calvinNdmb/Pixel-ai-dashboard/pixel-app/docs/AMIS.md

# Les amis de Pixel

Ton Pixel peut rendre visite au Pixel d'un copain, d'une maison à l'autre, comme le Pixel de poche part dans ton téléphone. Il sort de ton écran avec sa petite valise, arrive sur l'écran de son ami, à côté de lui, et ils jouent ensemble environ 3 minutes : ils se disent bonjour, dansent, se tapent dans les mains, font la course, goûtent, jouent à cache-cache, se racontent une blague, bavardent, font une photo souvenir… et s'endorment côte à côte s'il est tard. Puis il rentre chez toi et te raconte : « J'ai joué avec Bip ! On a dansé, et on a fait la course ! »

Rien ne passe par un serveur à nous, et tu n'as rien à ouvrir sur ta box : les deux Pixels se parlent par un **relais** public (ntfy.sh, ou le tien), et tout ce qui y passe est **chiffré** : le relais ne voit ni les noms, ni les codes, ni ce que font les Pixels. Tant que ton Pixel n'a pas d'ami, il ne contacte même pas le relais.

## Devenir amis

1. Sur le téléphone de ton Pixel, touche **Amis** sous les touches (le panneau **Ses amis**), puis **Créer mon code**. Ton code d'ami s'affiche : **trois mots et un nombre**, par exemple `lapin · soleil · tarte · 4271`, avec un QR code. Tu peux aussi le montrer en grand sur l'écran de Pixel (**Montrer sur l'écran de Pixel**, ou tape `mon code d'ami`).
2. Donne ce code à ton copain : lis-le-lui au téléphone, écris-le-lui, ou montre-lui le QR code (son appareil photo affiche le texte, il peut le copier).
3. Chez lui, sur son Pixel : panneau **Ses amis**, partie **Ajouter un ami**, il tape le code et touche **Ajouter**. Ou il tape la commande `ajoute l'ami lapin soleil tarte 4271`. Les majuscules, les accents, les tirets et les espaces ne comptent pas. Un mot mal tapé ? Le panneau le dit tout de suite, et propose le bon (« lapon » : « Tu voulais dire lapin ? »).
4. En une seconde, les deux Pixels sont amis : sur les deux écrans, Pixel fait la fête (« J'ai un nouvel ami ! Il s'appelle Bip ! ») et la tête de son ami passe le bout du nez dans le coin.

Le code marche **une seule fois**, pendant **24 heures**. Les deux Pixels doivent être allumés. Pour un autre ami, crée un autre code. **Annuler ce code** l'efface.

**Astuce :** donne d'abord un nom à ton Pixel (panneau **Caractère**, ou `appelle-toi Bip`) : c'est ce nom que voient ses amis. Deux amis qui s'appellent pareil deviennent « Pixel » et « Pixel 2 ».

## Les visites

- **Va le voir :** dans **Ses amis**, le bouton **Va le voir** à côté de ton ami. Ou tape `va voir Bip`. Ou demande à Claude « va voir Bip ».
- Ton Pixel quitte ton écran avec sa valise. À la place, une petite maison : « Chez Bip », le temps qu'il reste, et le bouton **Rappelle-le** (touche-le pour le faire rentrer tout de suite ; tape aussi `reviens`).
- Chez Bip, il entre par la droite, Bip se pousse un peu à gauche, et ils jouent. Leurs noms sont écrits sous eux. Ton Pixel garde le look qu'il a choisi (s'il en a un), habillé par la saison et la météo de chez Bip, dans les couleurs du thème de Bip.
- À la fin, il rentre et raconte ce qu'ils ont fait. La visite va dans le journal de **Ses amis**, et dans son album s'il en a un.
- **Bip ne répond pas ?** Au bout de 25 secondes, ton Pixel revient : « Bip n'a pas répondu… il doit dormir. » Son Pixel est peut-être éteint.
- **Bip ne peut pas ?** Ton Pixel revient et te dit pourquoi : il dort (de son coucher à son réveil, pendant sa sieste ; sans emploi du temps, ses heures calmes), il est occupé (quelque chose est casté sur son écran, il joue à un de ses jeux, ou il vient d'avoir de la visite et se repose 5 minutes), il fait des maths (un exo est ouvert), il a déjà de la visite, il est lui-même parti en visite, ou il ne reçoit pas de visite en ce moment. Si vous partez chacun chez l'autre en même temps : « On s'est croisés ! » Et ton Pixel lui-même ne part pas quand il dort, pendant un exo, une partie, ou quand il est dans ta poche.
- **L'heure du dodo pendant une visite :** si ton Pixel s'endort chez Bip (son coucher, sa sieste), il rentre ; si c'est Bip qui s'endort pendant qu'il est chez toi, Bip dit au revoir et repart.
- **Un souvenir et une photo par jour et par ami :** la première visite du jour avec Bip (chez lui ou chez toi) va dans l'album ; les suivantes, le même jour, vont seulement dans le journal.

**Quand un ami vient chez toi**, tu n'as rien à faire : il entre, ils jouent, il repart. Touche-le : il rigole. **Raccompagner** (dans **Ses amis**) le fait repartir plus tôt.

**Sur l'écran du Pi, une chose à la fois :** ce que tu castes, le menu rapide et un exo ouvert passent devant la visite, et une partie aussi (mais pas de partie pendant une visite, ni de visite pendant une partie). Elle attend dessous, son temps continue, et revient après. Pendant une visite, l'assiette des repas se range, et Pixel ne te propose ni question de maths ni partie, ne te demande pas comment tu vas et ne montre pas son album : tout cela revient après. Une blague, un repas, une photo, un nouveau look pendant la visite : ton Pixel le fait, son ami le regarde, puis ils reprennent là où en est la visite. Un coucou ou un autocollant arrivé pendant une partie ou un exo attend leur fin pour se montrer.

## Coucous et autocollants

- **Coucou** fait coucou à ton ami : sur son écran, ta tête passe dans le coin et le salue. Tape aussi `dis coucou à Bip`.
- **Autocollant** : un des 12 dessins (un cœur, une étoile, un soleil, un arc-en-ciel, un pouce levé, un fou rire, une fleur, un gâteau, une fusée, un cadeau, une note de musique, un bisou). Tape aussi `envoie un cœur à Bip`.
- Il n'y a **pas de texte libre** entre deux maisons : seulement ces coucous, ces autocollants et les visites.
- Si son Pixel dort, le coucou attend dans son journal.

## Réglages et parents

Dans **Ses amis**, partie **Réglages** :
- **Accepter les visites** (allumé au départ) : éteint, les amis ne peuvent plus venir.
- **Me demander avant** (éteint au départ) : quand un ami frappe, Pixel affiche « Bip veut venir jouer ! » avec **Non merci** et **Oui !**, sur son écran et dans le panneau. Sans réponse en 45 secondes, c'est non.
- **Amis** : l'interrupteur des parents. Éteint, plus rien ne sort ni n'arrive : pas de visite, pas de coucou, plus de connexion au relais.
- Pour verrouiller pour de bon, sur le Pi : `enabled = false` dans la partie `[amis]` de `config.toml` (le bouton du téléphone ne le rallume pas).

**Retirer un ami :** **Retirer** (touche deux fois). Les deux Pixels oublient l'amitié et sa clé. Si son Pixel est éteint plus de 12 heures, il ne l'apprendra pas tout seul : retire-le aussi de son côté.

**Le journal** (« Ce qui s'est passé ») garde les 30 dernières choses : nouveaux amis, visites dans les deux sens et ce qu'ils ont fait, refus, coucous, autocollants.

**Au plus 20 amis.**

## Ce qui protège les enfants

- Seuls les Pixels qui ont échangé un code peuvent joindre le tien. Le code marche une fois, 24 heures, et ne voyage jamais (ni dans le relais, ni ailleurs).
- Aucun texte libre, aucune photo, aucune position, aucun prénom ne passe d'une maison à l'autre. **Ce qu'un ami apprend, exactement :**
  - sa carte : le nom de ton Pixel (des lettres, 16 au plus), son caractère, son thème, le look que tu lui as choisi (forme et couleur des yeux, couleur des joues, accessoires choisis, et si les tenues des saisons et le pyjama sont permis), et un numéro au hasard. Jamais ce qu'il porte en ce moment : son pyjama dirait l'heure de son coucher, son chapeau de fête le jour de ton anniversaire. L'écran de ton ami l'habille lui-même, avec sa propre date ;
  - quand ton Pixel répond (il est allumé), et, quand une visite est refusée, pourquoi : il dort (sa nuit ou sa sieste), il est occupé (un cast, ou il se repose après une visite), il fait des maths, il est sorti ou dans ta poche, il a déjà de la visite, il ne reçoit pas de visite, ta famille a dit non ou n'a pas répondu ;
  - pendant une visite chez toi : ce qu'ils ont fait, la durée prévue, et s'ils ont fait la sieste côte à côte (chez toi, après 20 h) ;
  - les coucous, les autocollants et les visites que tu lui envoies, et quand ; le retrait de son Pixel de tes amis (« au revoir »).
- Tout ce qui passe par le relais est chiffré et signé : un message modifié, rejoué, trop vieux ou pas pour toi est jeté.
- Tout est limité : 20 amis, un coucou toutes les 20 secondes par ami, un autocollant toutes les 8 secondes, 150 messages par jour (rien de plus ne part, pas même une réponse), une visite à la fois, 30 messages par minute reçus d'un même ami (le reste est jeté sans être lu).
- Et ce qu'un Pixel ami peut faire faire au tien, même un Pixel modifié qui ne respecte aucune règle : ses demandes de visite sont écoutées au plus une toutes les 25 secondes et 20 par heure (les autres restent sans réponse) ; les réponses automatiques s'arrêtent avant les 30 derniers messages du jour, gardés pour les tiens ; après une visite (ou un « Non merci »), ton Pixel se repose 5 minutes (`repos_secondes` dans `[amis]` de `config.toml`) ; un souvenir et une photo par jour et par ami ; ses messages ne font écrire `amis.json` qu'une fois toutes les 10 secondes au plus.
- Un code d'ami tapé par un Pixel qui se présente avec le numéro d'un de tes amis est refusé (« Bip est déjà ton ami ! ») : personne ne peut prendre la place d'un ami.
- Au plus 6 nouveaux codes en 10 minutes ; leur calcul (scrypt) se fait un à la fois, à part.
- L'interrupteur **Amis** et le verrou de `config.toml`, le journal pour voir ce qui s'est passé, **Me demander avant** pour décider de chaque visite.

## Sans Pi, et dans Pixel Lab

**Pixel sans Pi** (l'appli Android sans le Pi) n'a pas encore d'amis : ses amis et leurs clés vivent sur le Pi. Les commandes des amis disent « Relie Pixel à ton Pi pour ça ».

**Pixel Lab** a un ami de démo, **Bip**, joué par un faux relais dans la page (rien ne sort de la page) : dans le panneau **Les amis**, **Il vient te voir** fait venir Bip (avec les mêmes scènes que sur le Pi), **Va voir Bip** envoie Pixel chez lui, **Il fait coucou**, ses autocollants, **Il dort**, **Il ne répond pas**, et chaque scène à deux, toute seule. Les visites y durent 30 secondes (**Visites courtes**). **Un copain tape mon code** te fait un nouvel ami de démo. Tu peux aussi taper n'importe quel code bien formé dans **Ajouter un ami**.

## Ton propre relais

Le relais par défaut est [ntfy.sh](https://ntfy.sh), un service public et gratuit (il garde les messages 12 heures, puis les efface). Tu peux en installer un à toi (ntfy est un logiciel libre : `docker run -p 80:80 binwiederhier/ntfy serve`, ou sur un petit serveur), puis, dans `config.toml` :

```toml
[amis]
relay = "https://ntfy.mamaison.fr"
# token = "tk_..."          # si ton relais demande un jeton d'accès
```

Les deux Pixels amis doivent utiliser le même relais. Rien d'autre n'est demandé au relais que de transmettre des messages qu'il ne peut pas lire.

---

## Comment c'est fait (pour les curieux et les développeurs)

**Fichiers.** `pixel/relais.py` : le client ntfy et la boîte chiffrée ; `pixel/amis.py` : les codes, les amitiés, les visites, les commandes, l'outil de Claude, `amis.json` ; `web/amis.js` : l'écran du Pi et le panneau du téléphone ; `web/scenes/amis.js` : les scènes (la part de l'hôte, `S(...)`, et celle du visiteur, `PixelAmisDuo`), les autocollants et les accessoires (`PixelAmisArt`), les mots de ce qu'ils ont fait ; `web/lab/amis-lab.js` : le miroir du labo et son ami de démo ; `tests/test_amis.py`, `tests/test_amis.js`, `tests/fake_ntfy.py`.

**Le relais (ntfy).** Publier : `POST {relais}/{sujet}` (le corps est le message, du texte ; en-tête `X-Firebase: no`). S'abonner : `GET {relais}/{s1},{s2},…/json?since={heure unix}`, une ligne JSON par message (`open`, puis les messages gardés depuis `since`, puis chaque nouveau, et un `keepalive` toutes les 45 s). Pixel garde **un seul flux** pour tous ses sujets, ouvert seulement quand il y en a un (un ami, un code, un code tapé). Coupé, il se reconnecte avec une attente qui double (1 s à 5 min, avec un peu de hasard), et reprend avec `since=` (l'heure de son dernier message, gardée dans `amis.json`) : une coupure ne fait rien perdre de ce que le relais garde. 120 s sans rien : la liaison est morte, il se reconnecte. Un refus du relais (429) est dit, jamais réessayé en boucle.

**La boîte.** Chaque message est du JSON, complété par des espaces jusqu'à 512, 1 024 ou 2 400 octets (la première taille qui le contient : un coucou, une visite et une carte ont la même longueur sur le relais ; un Pixel 1.3.0 lit ces espaces comme du JSON ordinaire), chiffré en AES-256-GCM (nonce de 96 bits au hasard), avec le sujet comme donnée associée (copié sur un autre sujet, il ne s'ouvre plus) : `PXA1.` + base64url(nonce ‖ chiffré ‖ étiquette), soit 725, 1 408 ou 3 243 caractères (3 600 au plus). Paquet Python `cryptography` (dans `requirements.txt`, vérifié par `deploy/install.sh`).

**Ce que le relais voit quand même.** Celui qui tient le relais (ntfy.sh, ou toi) ne lit rien, mais il voit : les adresses IP des maisons qui publient et qui écoutent, les sujets (au hasard, mais les mêmes pour toute une amitié : deux par amitié, un seul flux par Pixel qui les écoute tous, donc combien d'amis a un Pixel et lesquels il partage avec qui), quand chaque message passe, et sa taille parmi les trois. Il sait donc qui parle à qui, quand et combien, pas ce qu'ils se disent.

**Le code d'ami.** Trois mots d'une liste de 512 (dans `web/amis.js` : des mots simples, sans deux qui se prononcent pareil) et un nombre de 1000 à 9999 : 512³ × 9000 ≈ 1,2 × 10¹² codes, **40,1 bits**. Le code est étiré par scrypt (n = 2¹⁵, r = 8, p = 1 : 32 Mo et environ une demi-seconde sur un Pi 4, à l'abri du serveur), puis HKDF-SHA256 en donne le **sujet de rendez-vous** et sa **clé**. Le code ne voyage jamais. Quelqu'un qui copierait tout le trafic du relais devrait essayer 10¹² codes à une demi-seconde chacun.
**La limite, honnêtement :** le sel de scrypt est fixe (le même pour tous les Pixels : les deux côtés n'ont que le code en commun) et il n'y a pas d'échange authentifié par mot de passe (PAKE). Quelqu'un qui calculerait une fois pour toutes la table des 1,2 × 10¹² codes (des milliers d'années de calcul pour un seul ordinateur, mais une seule fois pour tous les Pixels) reconnaîtrait chaque sujet de rendez-vous qu'il voit passer sur le relais, donc son code. Pendant les 24 heures du code, il pourrait lire les deux cartes échangées, et même se glisser entre les deux Pixels à ce moment-là (répondre à la place de l'un et de l'autre). Une amitié déjà faite n'est pas touchée : sa clé vient aussi de l'échange X25519. Un PAKE fermerait cette porte ; Pixel n'en a pas encore.

**Devenir amis.** Celui qui tape le code (B) publie sur le sujet de rendez-vous, scellé avec sa clé : `bonjour` {sa clé publique X25519 éphémère, sa carte d'identité}. Le propriétaire du code (A), qui écoute ce sujet tant que le code vit, répond `bienvenue` {sa clé publique éphémère, sa carte}, et efface le code (une seule fois). Chacun calcule le secret X25519 et en tire la **clé de l'amitié** : HKDF(secret, sel = le code étiré, info = « pxa1 ami » + SHA-256(clé de B | clé de A | sujet)). Elle dépend donc du code (seul qui le connaissait pouvait participer) et de l'échange (deviner le code plus tard n'ouvre rien : confidentialité persistante). B dit enfin `merci` sur le canal de l'amitié (deux fois, à 15 s d'écart) : A sait alors que B a la même clé, et les deux écrans montrent le nouvel ami. Un `bonjour` de plus de 2 minutes est ignoré (son auteur a abandonné) ; sans réponse en 90 s, B le dit ; A plein (20 amis) répond `complet`. Une carte qui porte le numéro d'un ami déjà là n'est jamais acceptée, ni par A (il répond `deja`, garde son code et dit « Bip est déjà ton ami ! ») ni par B (« Ce Pixel est déjà ton ami ! ») : on ne remplace pas un ami (pour refaire une amitié, chacun retire d'abord l'autre).

**La carte d'identité** (ce qu'un ami sait de l'autre, avec ce que disent les messages ci-dessous ; prête pour un futur village) : `{v: 1, id: 16 chiffres hexadécimaux au hasard, nom: le nom de son Pixel (pixel/caractere.py, nettoyé, 16 caractères au plus), caractere: son caractère tout prêt ou « perso », theme: son thème, look: le look choisi pour lui (yeux, couleur_yeux, couleur_joues, mono, accessoires, saisons, nuit : ses choix de `pixel/look.py`, jamais `porte`, ce qu'il porte en ce moment, ni `sans`, `change`, `avant` ; 1 Ko au plus, 4 niveaux, des clés simples, des textes de 64 caractères au plus)}`. L'écran de l'ami l'habille lui-même (saison, nuit) avec sa propre date ; dans la carte d'un Pixel plus ancien, `porte` est jeté à l'arrivée. Elle est renvoyée à ses amis quand elle change (au plus tous les quarts d'heure).

**Le canal d'une amitié.** De la clé de l'amitié, HKDF tire deux sujets (un par sens : « boite » + l'id du destinataire) et deux clés (« id de l'expéditeur > id du destinataire ») : un message renvoyé à son auteur, ou copié vers un autre ami, ne s'ouvre pas. Chaque message porte `{v, k (son type), de, a, t (heure en ms), id (16 hex au hasard)}` et il est refusé si : il ne s'ouvre pas, il n'est pas pour moi ou pas de cet ami, il vient du futur (plus de 10 min), il est trop vieux (une demande de visite : 90 s ; une réponse : 3 min ; la fin d'une visite : 20 min ; le reste : 24 h), ou son `id` a déjà été vu (les id des dernières 24 h sont gardés dans `amis.json`, donc même après un redémarrage).

**Les types de messages :** `merci`, `carte` {carte}, `au-revoir` (on oublie l'amitié), `coucou`, `sticker` {s : un des 12}, `visite-demande` {vid}, `visite-attente` {vid} (l'hôte demande à sa famille), `visite-ok` {vid, dur}, `visite-non` {vid, pourquoi : dort, occupe, exo, absent, visite, ferme, non, pas-repondu, croise}, `visite-fin` {vid, fait : ce qu'ils ont fait (des scènes de la liste), par : fin, hote, rappel}. Aucun champ de texte libre.

**Une visite.** L'hôte vérifie qu'il peut (réveillé : `endormi()` de `pixel/habitudes.py`, son emploi du temps de son coucher à son réveil et sa sieste, sinon les heures calmes de son caractère ; pas de cast, pas d'exo ouvert, pas de partie, pas déjà en visite, visites acceptées), puis fixe le **programme** (`programme()` : il arrive, des activités au hasard tant qu'elles tiennent, la photo souvenir, la sieste côte à côte s'il est tard (son coucher dans l'heure ; sans emploi du temps, après 20 h), au revoir ; environ 3 minutes, `visite_secondes` dans `config.toml`), que tous ses écrans jouent scène par scène à l'heure du serveur ; une scène d'une autre fonction (une blague, un repas, une photo…) se joue jusqu'au bout, puis la visite reprend là où en est son heure. À la fin, il envoie `visite-fin` avec ce qu'ils ont fait ; le visiteur rentre et le raconte. L'hôte écrit alors le souvenir de la visite, et la photo prise ensemble (« ami-photo », avant la fin) l'attend, pour aller avec ce souvenir-là. S'il s'endort pendant la visite (son coucher, sa sieste), l'hôte avance son au revoir (après sa propre « Bientôt l'heure du dodo ») ; le visiteur qui s'endort chez son ami envoie `visite-fin` (par : rappel) et rentre. Le visiteur rentre de lui-même 30 s après la fin prévue si l'hôte s'est tu, et au bout de 25 s sans réponse à sa demande.

**L'état « amis »** (ce que voient les écrans) : `{dispo, pourquoi, on, visites, demander, relais, lien (off, connexion, ok, coupe), max, moi (ma carte), code: {code, mots, nombre, expire, qr} | null, montre, ajout: {etat, pourquoi, nom, t} | null, amis: [{id, nom, caractere, theme, look, depuis, vu, visite, n, coucou}], arrivent, visite: {vid, sens (sortie | accueil), ami, nom, etat (demande, attente, chez, question), t0, jusqua, fin, programme, look, seed, par} | null, evs: [les dernières nouvelles], journal: [30]}`. Jamais les clés.

**Les actions :** `amis.code`, `amis.code_annule`, `amis.montre {on}`, `amis.ajoute {code}`, `amis.ajout_ok`, `amis.visite {ami}`, `amis.rappel`, `amis.raccompagne`, `amis.reponse {vid, oui}`, `amis.coucou {ami}`, `amis.sticker {ami, s}`, `amis.retire {ami}`, `amis.reglages {on, visites, demander}`. **Commandes :** `va voir Bip`, `dis coucou à Bip`, `envoie un cœur à Bip`, `mes amis`, `mon code d'ami`, `ajoute l'ami …`, `reviens` (seulement quand il est parti) ; un nom qui n'est pas celui d'un ami part à Claude, comme avant. **Claude :** l'outil `pixel_friends` {action : liste, visite ou coucou ; ami : son nom} ; il ne peut ni ajouter ni retirer d'ami, ni écrire.

**`amis.json`** (dans le dossier de données, lisible par son seul propriétaire : il garde les clés) : mon id, les réglages, les amis (carte, clé, dates, nombre de visites), le code en cours, le journal, les id déjà vus, `since`, le compte du jour, les amis dont la visite a déjà fait le souvenir et la photo du jour. Un fichier illisible est mis de côté (`amis.json.illisible`) et Pixel repart sans ami ; une valeur d'un mauvais type (une liste à la place d'un mot…) est seulement laissée de côté.

**Le futur village.** Les cartes d'identité (id, nom, caractère, thème, look), la liste des amis et leurs dates sont faites pour être réutilisées par un village où les Pixels cohabitent : il suffira d'un nouveau type de message, sans rien changer aux amitiés.

**Ce qui n'est vérifié qu'avec un vrai second Pi :** le vrai ntfy.sh (son `since`, ses limites, ses keepalives), le délai réel d'une maison à l'autre, scrypt sur un Pi 4, et une visite sur le vrai écran de 7 pouces. Les tests utilisent un faux relais (`tests/fake_ntfy.py`), jamais ntfy.sh.

```
python3 tests/test_amis.py      # le faux relais sur le port 8460 (AMIS_PY_PORT=… pour un autre)
node tests/test_amis.js         # le faux relais 8461, deux serveurs de démo 8462 et 8463 (AMIS_RELAY_PORT, AMIS_A_PORT, AMIS_B_PORT) ; --shots DOSSIER
```
