calvinNdmb/Pixel-ai-dashboard/cute-kit/stl/CatEarInnerLeft.stl

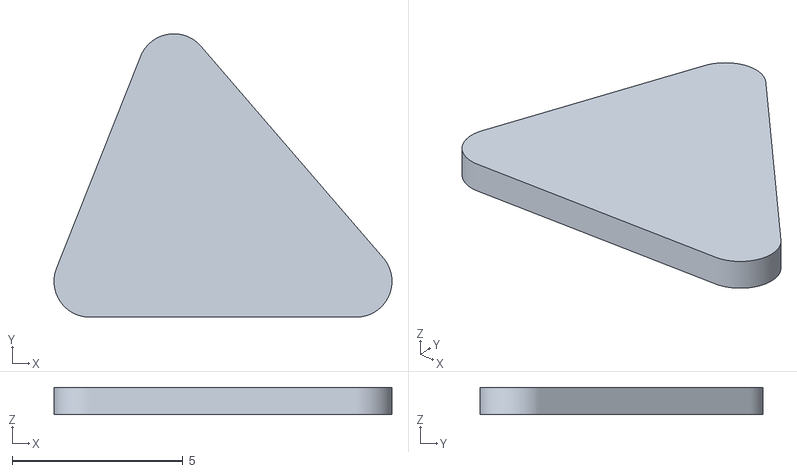
[picture p19: CAD file, 2026-11-05]
cute-kit/stl/CatEarInnerLeft.stl
9.90 x 8.30 x 0.8
