calvinNdmb/Pixel-ai-dashboard/pixel-desk/stl/ScreenFitTest.stl

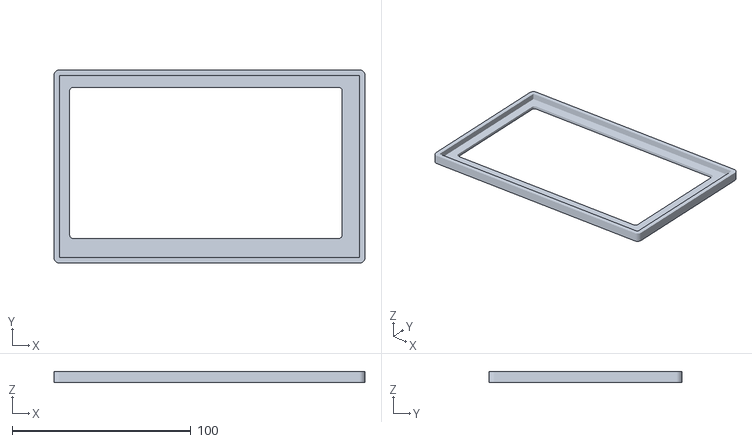
[picture p20: CAD file, 2026-11-09]
pixel-desk/stl/ScreenFitTest.stl
174.0 x 108.0 x 6.00
