calvinNdmb/Pixel-ai-dashboard/stream-deck-dock/stl/StreamDeckDock_MK2.stl

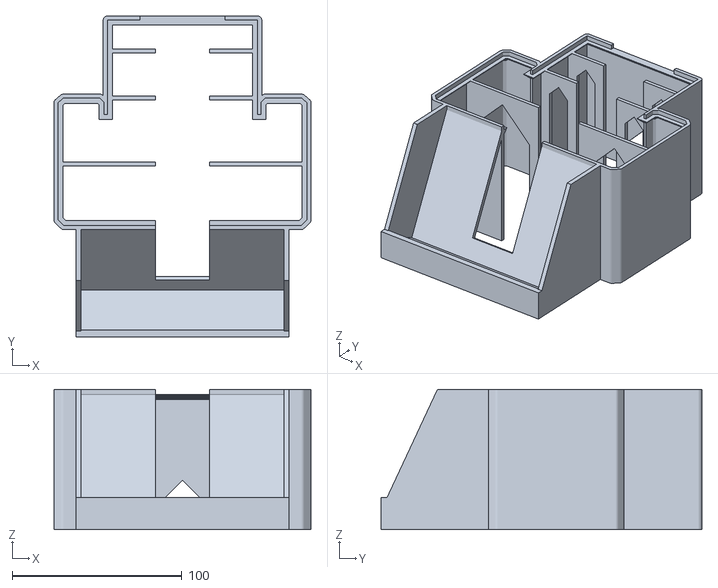
[picture p21: CAD file, 2026-11-05]
stream-deck-dock/stl/StreamDeckDock_MK2.stl
151.4 x 189.1 x 82.6
