calvinNdmb/Pixel-ai-dashboard/touch-head/stl/TouchHead.stl

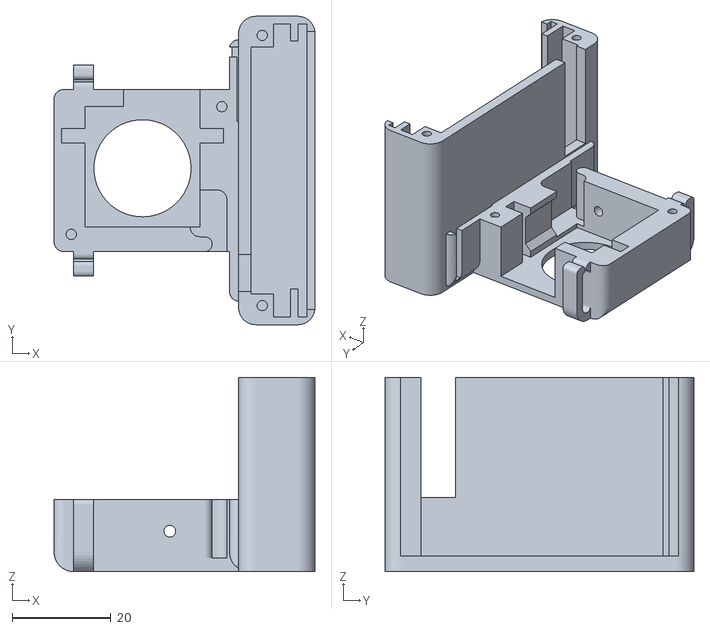
[picture p22: CAD file, 2026-11-05]
touch-head/stl/TouchHead.stl
53.0 x 62.6 x 39.4
