calvinNdmb/Pixel-ai-dashboard/cute-kit/stl/CatEarLeft.stl

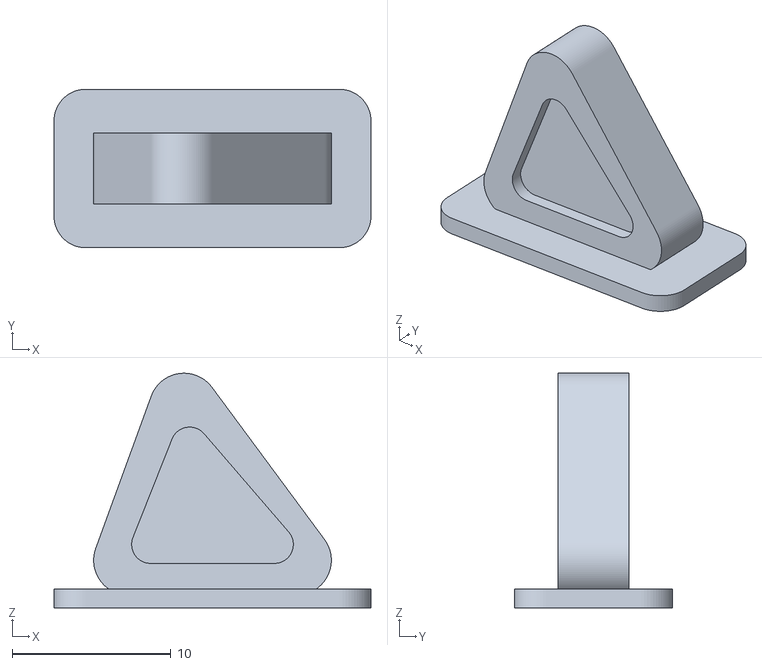
[picture p23: CAD file, 2026-11-05]
cute-kit/stl/CatEarLeft.stl
20.0 x 10.0 x 14.8
