calvinNdmb/Pixel-ai-dashboard/pixel-desk/stl/ScreenMountTest.stl

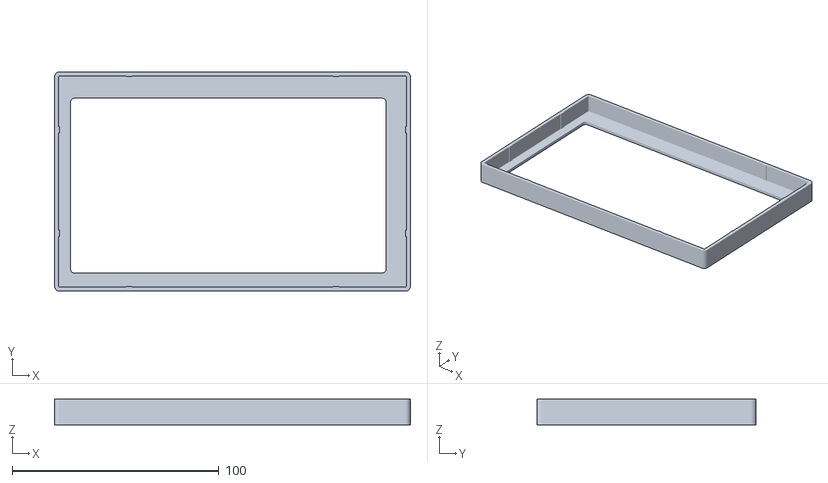
[picture p24: CAD file, 2026-11-09]
pixel-desk/stl/ScreenMountTest.stl
172.0 x 106.0 x 12.4
