calvinNdmb/Pixel-ai-dashboard/stream-deck-dock/stl/StreamDeckDock_Neo.stl

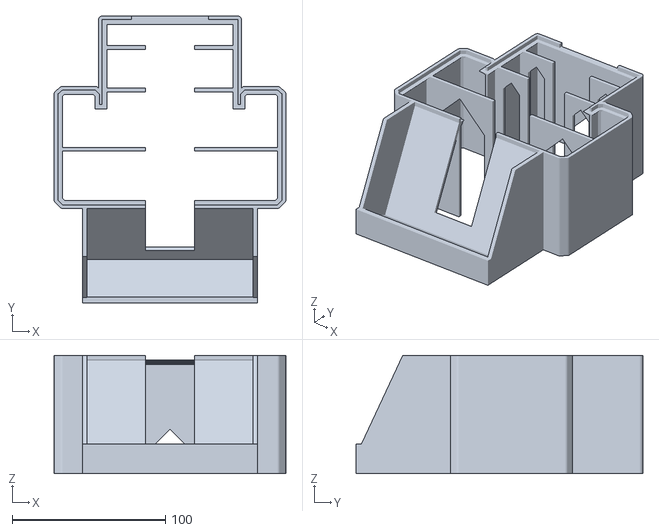
[picture p25: CAD file, 2026-11-05]
stream-deck-dock/stl/StreamDeckDock_Neo.stl
151.4 x 187.4 x 77.1
