calvinNdmb/Pixel-ai-dashboard/touch-head/stl/TouchHeadLid.stl

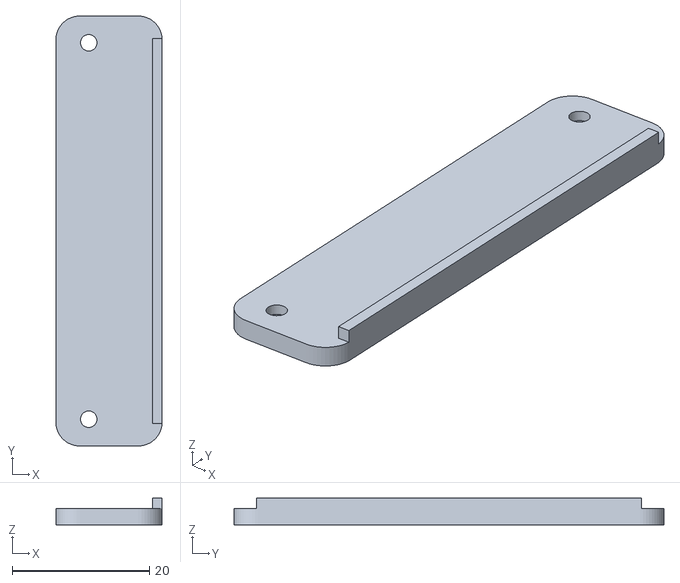
[picture p26: CAD file, 2026-11-05]
touch-head/stl/TouchHeadLid.stl
15.5 x 62.6 x 3.90
