calvinNdmb/Pixel-ai-dashboard/pixel-desk/stl/PixelMonitorBack.stl

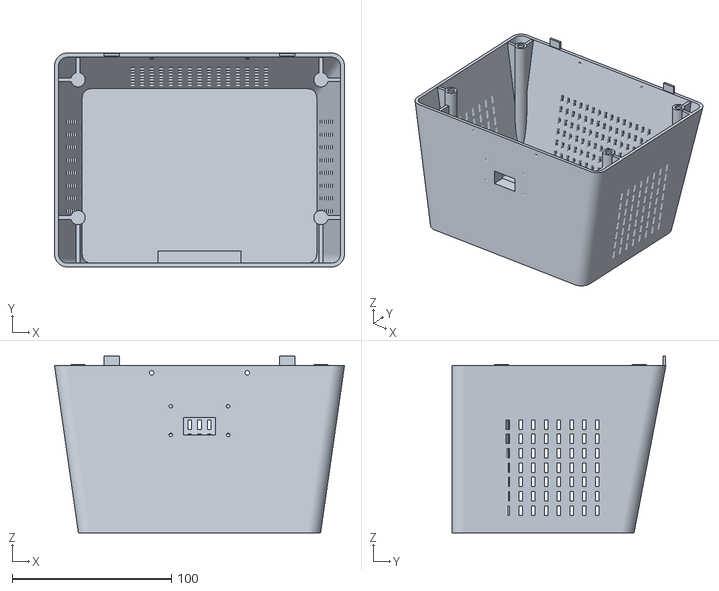
[picture p27: CAD file, 2026-11-09]
pixel-desk/stl/PixelMonitorBack.stl
182.0 x 134.3 x 111.0
