calvinNdmb/Pixel-ai-dashboard/touch-head/stl/TouchHeadHat.stl

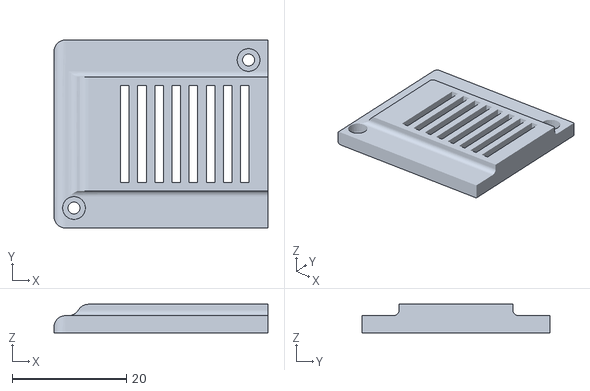
[picture p28: CAD file, 2026-11-05]
touch-head/stl/TouchHeadHat.stl
37.5 x 32.9 x 5.00
