calvinNdmb/Pixel-ai-dashboard/cute-kit/stl/BearEar.stl

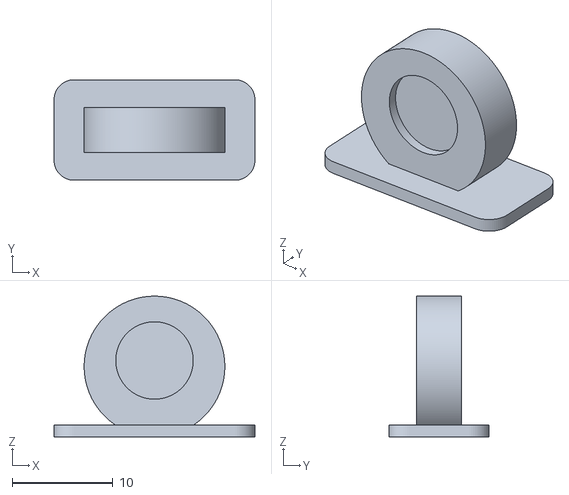
[picture p29: CAD file, 2026-11-05]
cute-kit/stl/BearEar.stl
20.0 x 10.0 x 14.0
