calvinNdmb/Pixel-ai-dashboard/pixel-desk/stl/PixelMonitorFront.stl

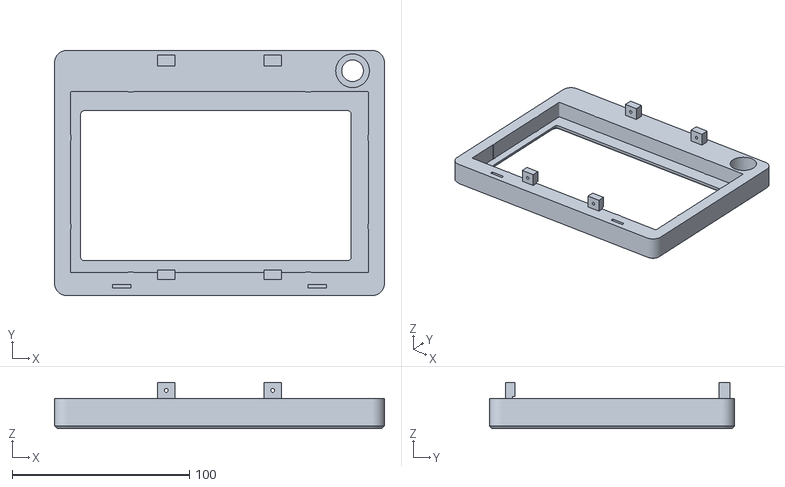
[picture p30: CAD file, 2026-11-09]
pixel-desk/stl/PixelMonitorFront.stl
186.0 x 138.2 x 26.0
