calvinNdmb/Pixel-ai-dashboard/cute-kit/stl/Blush.stl

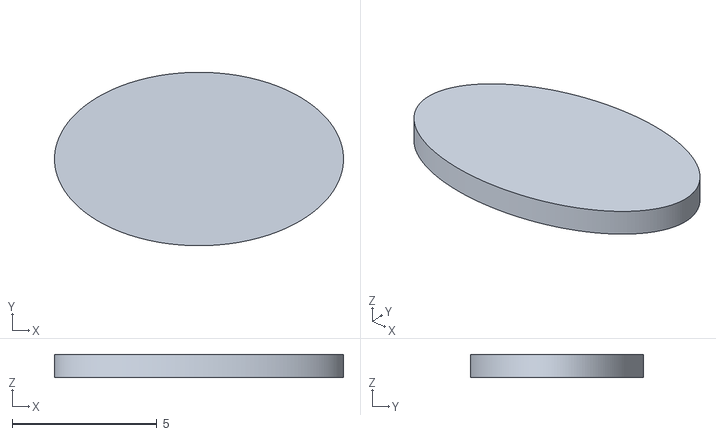
[picture p31: CAD file, 2026-11-05]
cute-kit/stl/Blush.stl
10.0 x 6.00 x 0.8
