calvinNdmb/Pixel-ai-dashboard/pixel-desk/stl/ScreenPostTest.stl

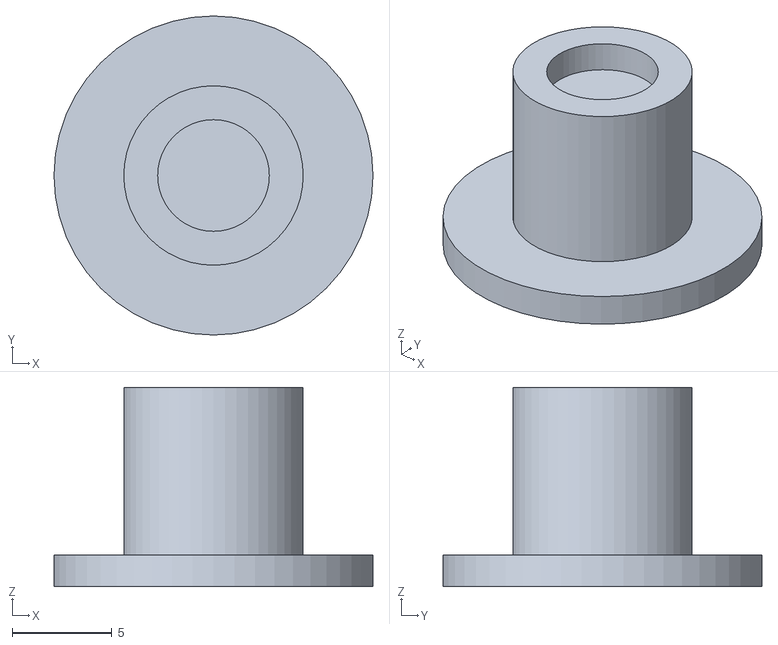
[picture p32: CAD file, 2026-11-08]
pixel-desk/stl/ScreenPostTest.stl
16.0 x 16.0 x 10.0
