calvinNdmb/Pixel-ai-dashboard/cute-kit/stl/HeartAntenna.stl

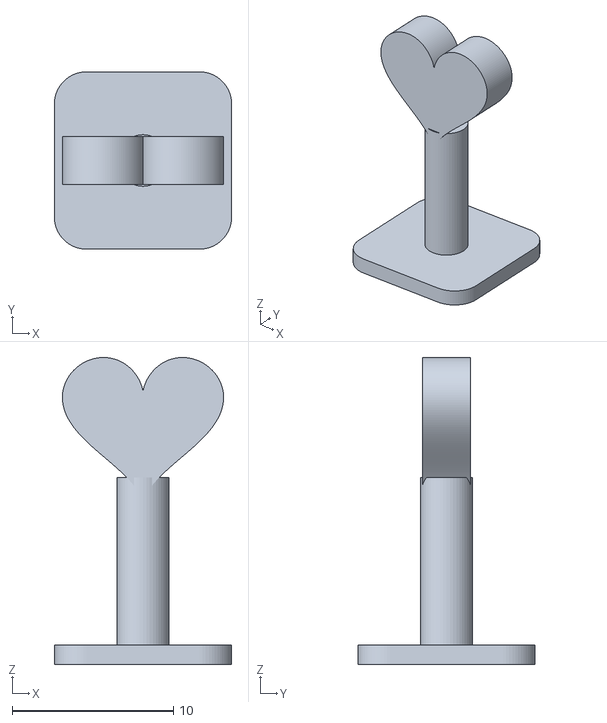
[picture p33: CAD file, 2026-11-05]
cute-kit/stl/HeartAntenna.stl
11.0 x 11.0 x 19.0
