calvinNdmb/Pixel-ai-dashboard/pixel-desk/stl/StreamDeckFitTest.stl

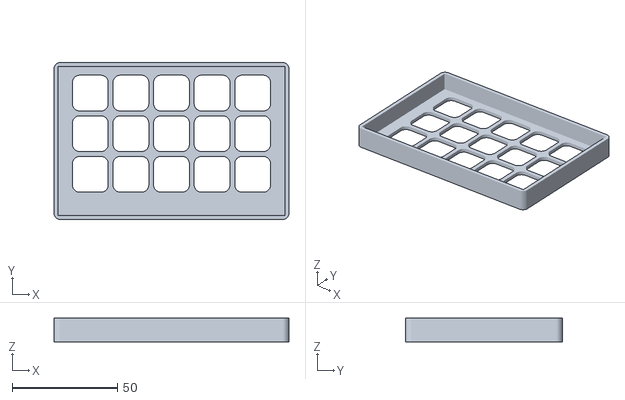
[picture p34: CAD file, 2026-11-07]
pixel-desk/stl/StreamDeckFitTest.stl
111.5 x 74.5 x 11.3
