calvinNdmb/Pixel-ai-dashboard/cute-kit/stl/BearEarInner.stl

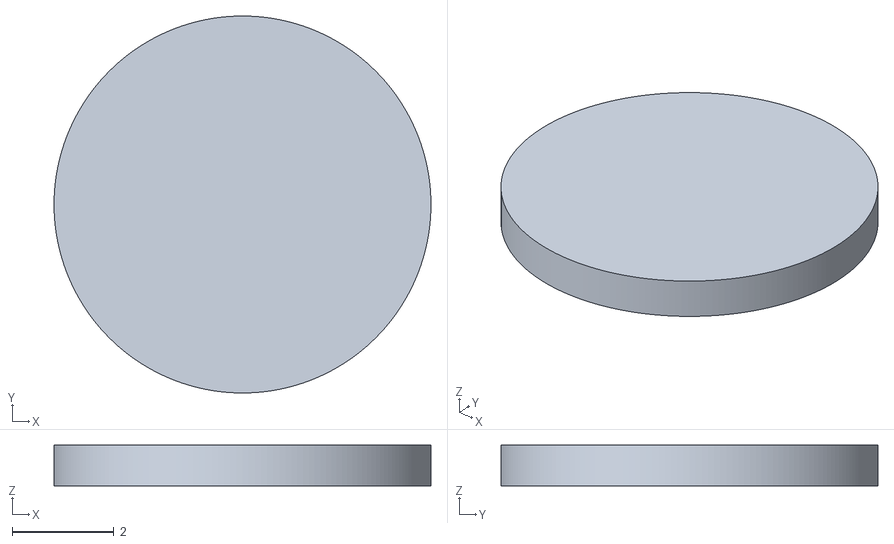
[picture p35: CAD file, 2026-11-05]
cute-kit/stl/BearEarInner.stl
7.40 x 7.40 x 0.8
