calvinNdmb/Pixel-ai-dashboard/pixel-desk/stl/PixelCase.stl

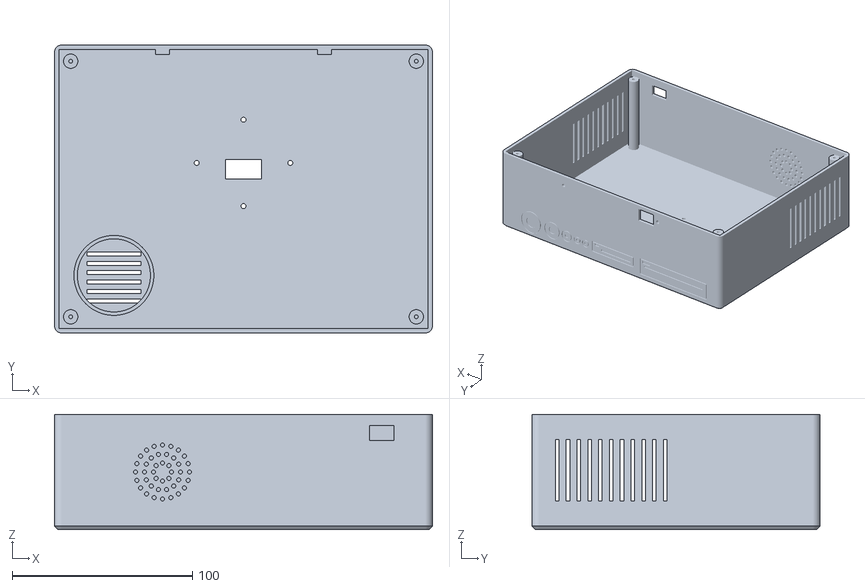
[picture p36: CAD file, 2026-11-06]
pixel-desk/stl/PixelCase.stl
210.0 x 160.0 x 64.0
