calvinNdmb/Pixel-ai-dashboard/pixel-desk/stl/PixelCaseBottom.stl

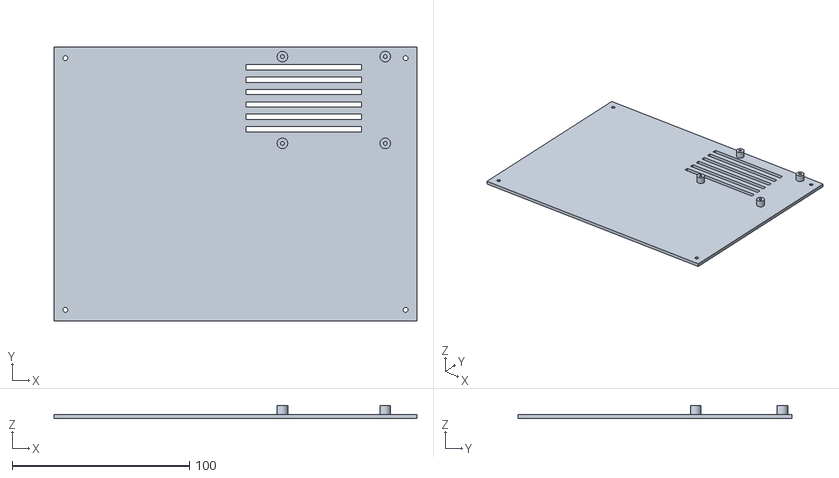
[picture p37: CAD file, 2026-11-06]
pixel-desk/stl/PixelCaseBottom.stl
204.8 x 154.8 x 7.40
