calvinNdmb/Pixel-ai-dashboard/pixel-desk/stl/PixelKeyboardBase.stl

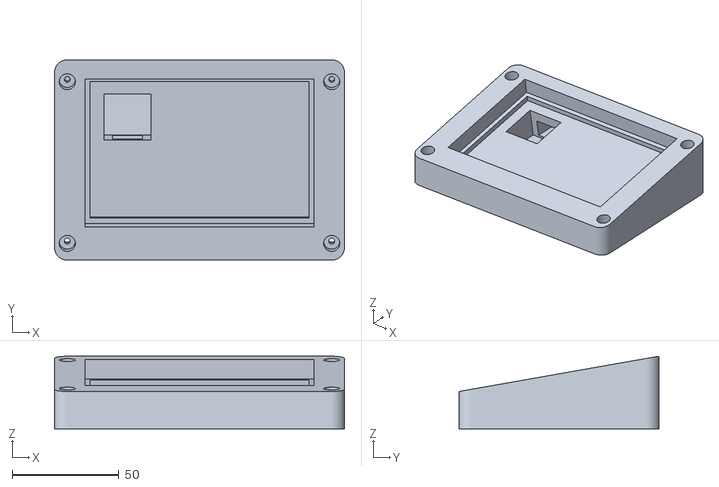
[picture p38: CAD file, 2026-11-06]
pixel-desk/stl/PixelKeyboardBase.stl
136.0 x 94.0 x 34.1
