calvinNdmb/Pixel-ai-dashboard/pixel-desk/stl/PixelKeyboardTop.stl

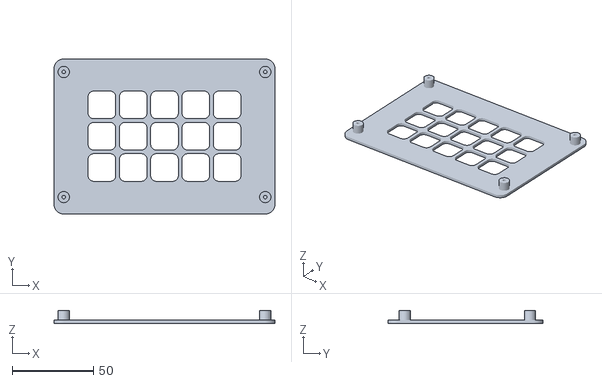
[picture p39: CAD file, 2026-11-06]
pixel-desk/stl/PixelKeyboardTop.stl
136.0 x 95.5 x 8.00
