calvinNdmb/Pixel-ai-dashboard/pixel-desk/stl/PixelStand.stl

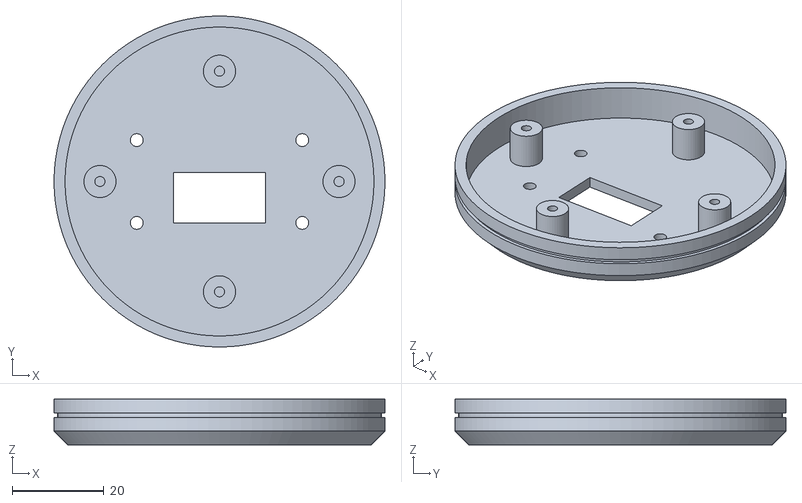
[picture p40: CAD file, 2026-11-06]
pixel-desk/stl/PixelStand.stl
72.0 x 72.0 x 10.0
