calvinNdmb/Pixel-ai-dashboard/pixel-desk/stl/PixelStreamDeckTray.stl

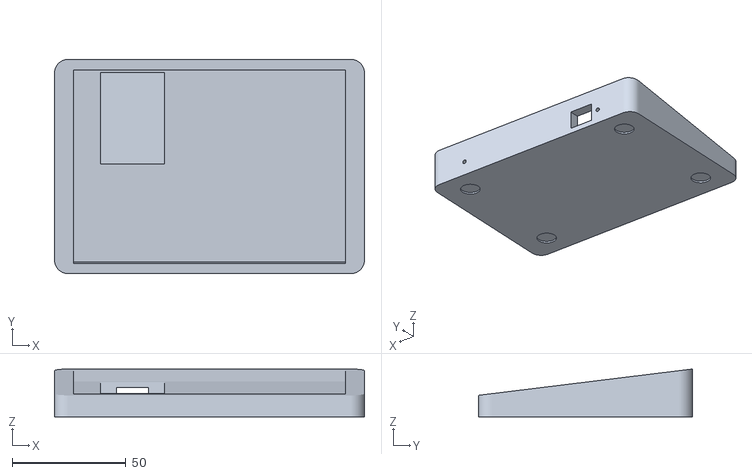
[picture p41: CAD file, 2026-11-06]
pixel-desk/stl/PixelStreamDeckTray.stl
136.0 x 94.0 x 21.0
