calvinNdmb/Pixel-ai-dashboard/(list of files, cad)

Other CAD files:
cute-kit/stl/CatEarRight.stl
cute-kit/stl/CatEarInnerRight.stl
