calvinNdmb/Pixel-ai-dashboard/pixel-desk/preview-print.png

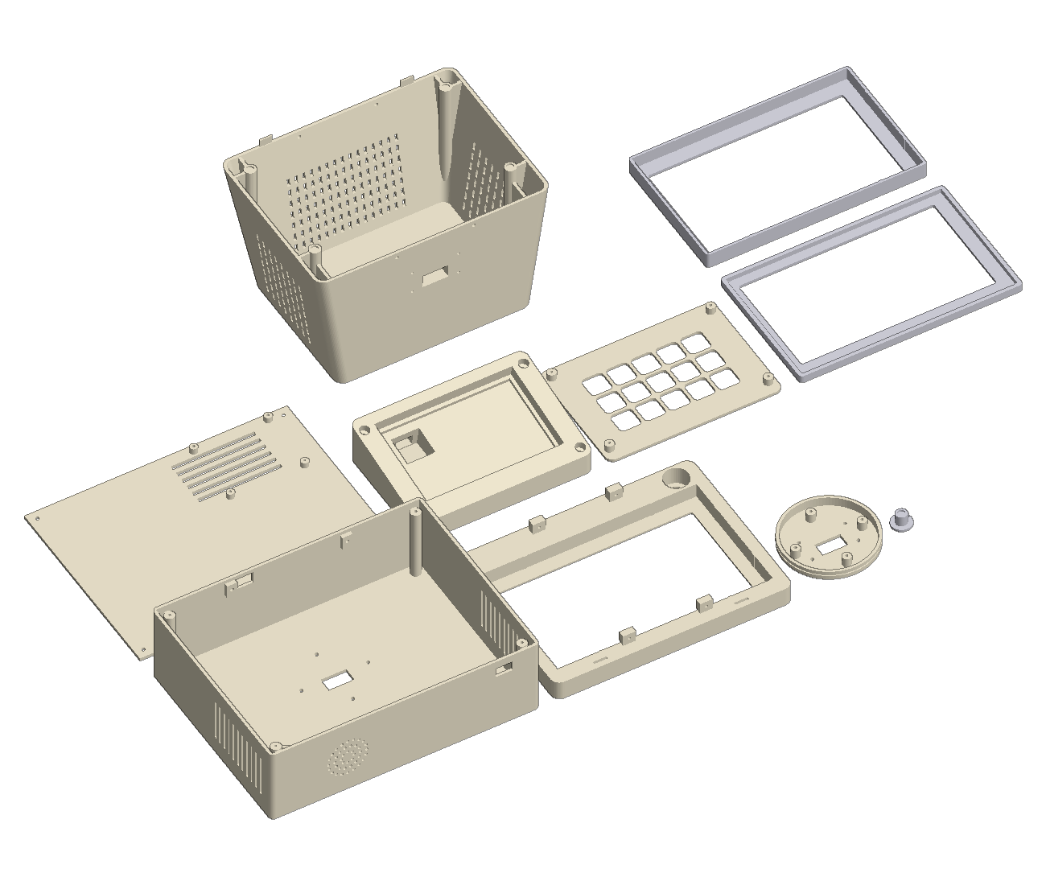
pixel-desk/preview-print.png
