calvinNdmb/Pixel-ai-dashboard/pixel-app/pixel/airplay.py

"""AirPlay on Pixel (optional): the « Recopie de l'écran » of an iPhone, an iPad or a Mac, with UxPlay.

    [airplay]
    enabled = true        # off by default: UxPlay must be installed first (install.sh with PIXEL_AIRPLAY=1, docs/CAST.md)

The server starts UxPlay (https://github.com/FDH2/UxPlay, 1.73 or later) in the desktop session (Wayland: it waits for its
socket), keeps it running (it starts again after a crash, more and more slowly if it crashes at once), and reads what it
writes, line by line. UxPlay has no other way to say what happens: no callback, no D-Bus. Its lines (UxPlay 1.73.7):

    Accepted IPv4 client on socket 23                     a connection (the iPhone's AirPlay menu opens some, to look)
    *** CLIENT MUST NOW ENTER PIN = "4821" AS AIRPLAY PASSWORD      -pin: the code Pixel shows, for the iPhone
    connection request from Marie's iPhone (iPhone14,2) with deviceID = 4A:...   an iPhone starts: its name
    raop_rtp_mirror starting mirroring                    the picture: AirPlay mode
    on_video_play: location = http://...                   -hls: a video from the YouTube app
    on_video_stop / hls video has sent EOS                 that video is over
    Connection closed on socket 23 / Removing connection for socket 23
    ERROR lost connection with client                      the iPhone went away (-reset 5: after 5 s of silence): UxPlay is
                                                           started again, and -nofreeze closes its window (else it keeps the
                                                           last picture full screen over Pixel)

The state's "cast" becomes {kind: "screen", via: "airplay", phase: pin | connecting | live, title, note, code}; UxPlay's own
window, full screen, covers Pixel's while the picture is there. Stopping the cast on Pixel (a touch, the phone's Arrêter,
another cast) restarts UxPlay, which sends the iPhone away. The state's "airplay" is {on, status, client, name, error} for the
phone app: status off, absent (no uxplay), attente (no Wayland session yet), pret, connecte, erreur.
"""
import asyncio
import logging
import os
import re
import secrets
import shutil
import time
from pathlib import Path

log = logging.getLogger("pixel")
PATTERNS = [                                   # (event, pattern): the first one that matches a line wins
    ("pin", re.compile(r'\*\*\* CLIENT MUST NOW ENTER PIN = "(\d{4,8})" AS AIRPLAY PASSWORD')),
    ("connect", re.compile(r"connection request from (.+?) \(([^()]*)\) with deviceID = (\S+)")),
    ("mirror", re.compile(r"raop_rtp_mirror starting mirroring")),
    ("hls", re.compile(r"on_video_play: location = (\S+)")),
    ("hls_end", re.compile(r"on_video_stop|hls video has sent EOS")),
    ("open", re.compile(r"Accepted IPv[46] client on socket (\d+)")),
    ("close", re.compile(r"(?:Connection closed on socket|Removing connection for socket) (\d+)")),
    ("lost", re.compile(r"ERROR lost connection with client")),
]
PIN_S, CONNECT_S = 90, 30                      # how long the code card and the "connecting" card stay without news


def parse(line):
    """(event, groups) for one of UxPlay's lines, or None."""
    for ev, rx in PATTERNS:
        m = rx.search(line)
        if m:
            return ev, m.groups()
    return None


class UxState:
    """What UxPlay's lines say, one after the other: phase idle, pin, connecting or live; the client's name; the code."""
    def __init__(self):
        self.reset()

    def reset(self):
        self.phase, self.client, self.pin, self.what, self.socks = "idle", "", "", "", set()

    def feed(self, line):
        """Returns True when the phase, the client or the code changed."""
        got = parse(line)
        if not got:
            return False
        ev, g = got
        before = (self.phase, self.client, self.pin, self.what)
        if ev == "open":
            self.socks.add(g[0])
        elif ev == "close":
            self.socks.discard(g[0])
            if not self.socks and self.phase != "idle":        # the last connection gone: the iPhone left
                self.reset()
        elif ev == "lost":
            self.reset()
        elif ev == "pin":
            self.phase, self.pin = "pin", g[0]
        elif ev == "connect":
            self.client = g[0].strip()[:60]
            if self.phase != "live":
                self.phase, self.pin = "connecting", ""
        elif ev == "mirror":
            self.phase, self.pin, self.what = "live", "", "mirror"
        elif ev == "hls":
            self.phase, self.pin, self.what = "live", "", self.what or "video"
        elif ev == "hls_end" and self.what == "video":
            self.phase, self.what = ("connecting" if self.client else "idle"), ""
        return (self.phase, self.client, self.pin, self.what) != before
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
