calvinNdmb/Pixel-ai-dashboard/(commit log)

2026-11-05 Add cute kit: stick-on ears, blush and heart antenna for the desk robot
    Printable STLs (no supports) plus the parametric generator and a preview
    render. Sized for the SG90 Tiny Engineer head (~53 mm wide) but they stick
    on with foam tape or glue, so they fit any head.
    Claude-Session: https://claude.ai/code/session_01TTtGvL7Svg5STn5aj1EHie
    [BearEar.stl, BearEarInner.stl, Blush.stl, CatEarInnerLeft.stl, CatEarInnerRight.stl, CatEarLeft.stl, CatEarRight.stl, HeartAntenna.stl]
2026-11-05 Add Stream Deck dock: robot on top, reclined Stream Deck slot underneath
    Printable, support-free dock for the SG90 Tiny Engineer build. The robot
    sits in a pocket that follows its real footprint; a 25 deg slot below holds
    a Stream Deck MK.2 or Neo, with a cable channel out of the back.
    Parametric generator, STLs for both decks and a preview render.
    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
    [StreamDeckDock_MK2.stl, StreamDeckDock_Neo.stl]
2026-11-05 Add touch-screen head for the Waveshare 2inch Capacitive Touch LCD
    Keeps the stock SG90 Head servo frame unchanged (cut from the upstream STL
    at a pinned commit, SHA-256 checked) and replaces the OLED box with a box
    for the 2" touch LCD: top-loading groove, glass back-stops, lid bosses and
    a cable notch. Includes a shortened stock Hat and a new lid, all
    support-free. Fit checked against Waveshare's STEP model: no collision
    installed or along the slide-in path. CERN-OHL-S-2.0 notice and licence.
    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
    [TouchHead.stl, TouchHeadHat.stl, TouchHeadLid.stl]
2026-11-06 Add Pixel: desk companion with 4.3" touch screen, Stream Deck MK.2 and Pi 4
    Static design (no servos): rounded head holding a Waveshare 4.3" DSI LCD,
    oval neck carrying the screen ribbon, and a base with a 40 deg Stream Deck
    slot, the Pi 4 compartment, speaker grille and vents. One power cable.
    Nine support-free parts plus a screen fit test, a parametric generator,
    previews and a French build guide. Fit checked against mock-ups of the
    Stream Deck, screen, Pi 4 with plugs and speaker.
    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
    [PixelBase.stl, PixelEarInner.stl, PixelEarLeft.stl, PixelEarRight.stl, PixelHeadBack.stl, PixelHeadFront.stl, PixelLid.stl, PixelNeck.stl]
2026-11-06 Pixel: remove the ears
    Drop the ear parts and their sockets in the head front; update previews
    and the build guide.
    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
    [PixelEarInner.stl, PixelEarLeft.stl, PixelEarRight.stl, PixelHeadFront.stl]
2026-11-06 Pixel: retro beige PC look
    Redesign as a 90s desktop PC: a CRT-style monitor (thick bezel with a
    sunken screen, engraved controls and badge, tapered vented back) on a
    swivel foot, a desktop case with engraved CD/floppy bays, power button
    and LEDs, and the Stream Deck MK.2 as the keyboard on a low tray in front.
    Seven support-free parts, all checked for collisions against the screen,
    Stream Deck (with a 90 deg USB-C plug), Pi 4 with plugs and speaker.
    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
    [PixelBase.stl, PixelCase.stl, PixelCaseBottom.stl, PixelHeadBack.stl, PixelHeadFront.stl, PixelKeyboardTray.stl, PixelLid.stl, PixelMonitorBack.stl]
2026-11-06 Pixel: deep CRT monitor
    Monitor back goes from 38 to 95 mm deep (115 mm overall) with a boxy 6 deg
    taper and perforated grilles on both sides and on top, like a real tube
    monitor. Case deepened to 130 mm to match. Screen posts thickened, the
    stand-screw block now ends in a 45 deg ramp. Re-checked: no collisions,
    no supports needed.
    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
    [PixelCase.stl, PixelCaseBottom.stl, PixelMonitorBack.stl]
2026-11-06 Pixel: beige retro keyboard for the Stream Deck MK.2 module
    The Stream Deck MK.2's inner module (107 x 70 x 9 mm, dimensions from the
    stagehacks Stream-Deck-Module drawing) now sits in a printed retro
    keyboard: a 10 deg base that clamps the module on its 2.5 mm rim, and a
    beige top with the 15 official 17 mm cutouts, an engraved key frame,
    PIXEL badge and three status LEDs. Fully reversible. The tray for an
    unopened Stream Deck stays as an option, with its plug pocket and the
    case's cable hole moved to the real USB-C position. All fits re-checked.
    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
    [PixelCase.stl, PixelKeyboardBase.stl, PixelKeyboardTop.stl, PixelKeyboardTray.stl, PixelStreamDeckTray.stl]
2026-11-06 Pixel app: the real software for the Raspberry Pi, phone and computer
    A small aiohttp server on the Pi serves one web app to Pixel's own 800x480
    screen (kiosk) and to phones and computers on the same Wi-Fi, and drives the
    Stream Deck MK.2 keys. Ten screens in the green-screen style of the mockup:
    face, Hue lights, Claude chat, Codex tasks, weather, focus timer, calendar,
    system, settings (QR code to open it on a phone) and screensaver.
    Typing works everywhere: the computer keyboard, the phone keyboard, a
    Bluetooth keyboard or an on-screen AZERTY keyboard on Pixel. Typed text is
    read as a command first (salon 40, minuteur 10, codex <task>...), and goes
    to Claude otherwise. Claude can act thr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
2026-11-06 Pixel OS: three themes (retro, modern, manga)
    The screen, the phone app and the Stream Deck keys can now switch between:
    - Rétro: the green CRT look, pixel-block face.
    - Moderne: night-blue background, big rounded glowing eyes that float,
    hop with squash and stretch and blink smoothly; chat in bubbles.
    - Manga: paper and screentone, big shiny anime eyes with highlights,
    blush, speed lines when surprised, snot bubble when asleep, speech
    balloons for Claude.
    themes.js draws backgrounds, headers, panels, bars, icons, weather and
    the eight face moods for each theme; screens.js uses it. The theme is
    picked from Réglages, the Stream Deck, a typed command (thème manga) or
    by asking Claude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
2026-11-06 Pixel: 7-inch screen, real buttons and real status LEDs
    The printable PC is resized for the Freenove 7" DSI touch screen
    (165 x 101 x 10 mm, from two published cases made for it): 190 x 135 mm
    bezel with a 160 x 94 mm window, 142 mm deep CRT back, bigger stand and a
    200 x 160 x 64 mm case. Everything prints on a 256 mm bed.
    The case front now has real parts instead of engravings: a 16 mm power
    button with LED ring, a 12 mm Turbo button, green and orange 3 mm LEDs in
    chrome holders and a 5 mm addressable RGB notification LED (teardrop holes,
    support-free). The keyboard's three status LEDs are a 3-LED piece of
    144 LEDs/m WS2812B strip under three windows filled by a translucent bar
    (PixelKeyb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
    [PixelCase.stl, PixelCaseBottom.stl, PixelKeyboardBase.stl, PixelKeyboardLeds.stl, PixelKeyboardTop.stl, PixelMonitorBack.stl, PixelMonitorFront.stl, PixelStand.stl]
2026-11-06 Pixel guide: no soldering
    Everything now plugs or screws in: a GPIO screw-terminal board on a
    40-pin ribbon takes every wire (two per screw to share 5 V), buttons are
    bought pre-wired, the LED strip keeps its factory connector (first three
    LEDs of the roll) with a JST pigtail, lever connectors join wires, and a
    USB mini speaker replaces the MAX98357A amplifier that needs soldered
    headers. Adds a solder-free wiring diagram for the LED strip and notes a
    solder-free way to feed the screen's 5 V.
    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
2026-11-06 Pixel app: Google Calendar and Samsung phone calendars
    The calendar now reads several calendars at once and they can be managed
    from the phone (new page /app/reglages.html, linked from the app): paste
    Google Calendar's secret iCal address (or any .ics / webcal:// address),
    or import a .ics / .vcs file, e.g. events shared from Samsung Calendar.
    Samsung Calendar also shows the phone's Google calendars, so events made
    there reach Pixel through the Google address.
    agenda.py: per-calendar errors instead of a crash, names from
    X-WR-CALNAME, a colour per calendar, events split across midnight and
    multi-day all-day events, cancelled events hidden, duplicates across
    calendars removed, addresses kept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
    [agenda.py]
2026-11-06 Pixel Lab: a test bench for every theme, mood, screen and event
    pixel-app/web/lab/ runs the real Pixel OS renderer (themes.js, screens.js)
    against an in-page fake server (demo-hub.js: same state shape, action names
    and typed-command parser as server.py), so it needs no server. It works on a
    computer, on a phone, and full screen on the Pi's 7" display (?kiosk=1).
    - pickers for every theme and mood (discovered from themes.js at runtime),
    the 10 screens, the 15 Stream Deck keys and every event
    - slow motion: clock.js wraps requestAnimationFrame and performance.now
    before screens.js loads (0.25x to 2x, pause, one frame)
    - guided tour, screenshot, and a screen test card for the real display: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
2026-11-06 Pixel desk v1: FNK0078H screen, solder-free faux Pi, v1/v2 switch, tools
    - V2_PANEL switch (False by default): v1 engraves the front-panel buttons
    and LEDs and the keyboard LED marks, without the LED strip pocket and
    the translucent bar; v2 keeps the real holes, windows, bar and pocket.
    main() still deletes stale STLs, so PixelKeyboardLeds.stl is v2 only.
    - Screen: Freenove's packing list gives 19.3 x 11.1 cm for the FNK0078H
    glass (the old 165 x 101 came from cases for the blue-board B/C). The
    monitor now follows the screen constants (bezel 205 x 139 mm, back
    201 x 135 mm) and the case grows to 210 mm.
    - PixelScreenPowerAdapter.stl, a "faux Pi": plate with the Pi 4 holes that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
    [PixelCase.stl, PixelCaseBottom.stl, PixelKeyboardBase.stl, PixelKeyboardLeds.stl, PixelKeyboardTop.stl, PixelMonitorBack.stl, PixelMonitorFront.stl, PixelScreenPowerAdapter.stl]
2026-11-06 Pixel OS: a living face, 15 moods and three new themes (néon, croquis, LCD)
    - PixelLife (web/themes.js): saccades with a slow drift, single and double
    blinks, idle hops, fidgets, stretches and yawns, squash under the finger and
    a bounce on release, eyes that follow the finger, rapid taps make him angry,
    petting makes him fall in love, 220 ms transitions between moods.
    - A shared vector rig (moods as numbers blended during a transition) for
    moderne, manga, néon and croquis; a pixel rig with an ordered-dither dissolve
    for rétro and LCD.
    - 7 new moods drawn by every theme: triste, fache, confus, excite, fier,
    malade, baille. Typed "humeur ...", Claude's set_mood, the Stream Deck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
    [claude.py, commands.py, deck.py, keys.py, sheets.py, test_claude_loop.py, test_pixel.py]
2026-11-06 Pixel OS: petting no longer blocks swipes on other screens; lab long press ignores a moving finger; agenda test in tests/
    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
    [test_agenda.py]
2026-11-06 Pixel OS: the user's 52-animation pack becomes Pixel's face
    - web/pack52/: the user's pack (pixel.js, pixel-themes.js) vendored with the
    globals renamed to Pixel52 / Pixel52Themes, plus animations.json and the
    catalogue. gif/ and sprites/ are not copied.
    - Face setting view.face = "pack" (default) | "vivant", saved like the theme:
    Réglages chips, commands "visage pack" / "visage vivant", lab switch.
    - The pack face is drawn in a 16:9 box over every theme: Rétro and LCD use the
    pack's pixels in their own colours, Moderne and Manga the pack's drawings,
    Néon the modern one with a bloom, Croquis the manga one in graphite.
    - Idle: weighted draw over the 18 idles, one loop each, never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
2026-11-07 pixel-desk: StreamDeckFitTest.stl, a quick print to check the Stream Deck key windows
    The real keyboard top's key field (same 15 windows from the new kb_key_windows()
    helper) on a 2 mm rim of the base's module pocket (mod_pocket(), MOD_DEPTH), so it
    follows any change to MOD_KEY_X/Y, KEY_CUT, KEY_R, MOD_W/H/T and MOD_CLR. Engraved
    "SD TEST", prints flat without supports: 112 x 75 x 11 mm, ~19 g, ~35 min on a P2S.
    The other STLs are unchanged byte for byte.
    verify.py checks it against the module and keys, compares its window outline and key
    margins with the real top, its pocket clearance and depth with the base, and its
    weight and rough print time. render.py --only sdtest makes preview-sdtes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
    [StreamDeckFitTest.stl]
2026-11-07 Pixel OS: draw 60 frames a second only while something moves fast
    - screens.js: a frame-rate governor. 60 im/s under a finger, 2.5 s after any
    input, after a change of screen or theme, during banners and quick
    animations; 30 for the idle face, 24 for the Rétro and LCD faces, 20-30 for
    weather, Claude, Codex and a running timer, 15 in Veille, 10 (20 in Néon and
    Moderne) on still screens. A new server state is drawn at once. ?fps=full
    restores 60 everywhere. Measured in Chromium: 40-70 % less CPU.
    - The Settings QR code is drawn once into a cached canvas (422 squares).
    - Lights bars keep full speed while they move, then land on the value.
    - Lab: "Économie d'images" switch, readout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
2026-11-08 Pixel OS: a personality - reactions, moods that last, moments of life
    - web/persona.js: what Pixel does when you touch him, when you come back and
    when nobody looks. 55 scenes built on the pack's animations: the whole face
    moves (swims, walks off screen, hides, bounces like the DVD logo, sulks in a
    corner), with props (hearts, tears, bubbles, a fly, a rain cloud, a sign) and
    speech bubbles in the theme's colours; Rétro and LCD draw them in the pack's
    pixels and redraw a smaller or bigger face with whole pixels.
    - Touch: the eye, the top of the head, the mouth, a side or next to him each
    get their own reaction. Taps in a row annoy him (he dodges, gets angry, then
    sulks and answ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
2026-11-08 Pixel OS: only the Rétro theme for now ([ui] themes in config.toml)
    - server.py: [ui] themes lists the themes Pixel offers; when the line is
    missing (the Pi's config), Rétro only. A saved theme that is off falls back
    to Rétro; theme.set and theme.step refuse the others with a message.
    - Stream Deck, Réglages: with one theme, Effet CRT and Visage Pack 52 /
    Vivant instead of Thème − / Thème +.
    - Commands: "thème néon", "thème suivant" say that only Rétro is on.
    - Claude: tools_for() leaves out set_theme with one theme, lists only the
    themes that are on otherwise.
    - Screen: no theme row on Réglages with one theme; only the fonts of the
    themes in use are loaded (Rétro alo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
    [claude.py, commands.py, keys.py, test_claude_loop.py, test_pixel.py]
2026-11-08 pixel-desk: screen mount test pieces for the blue-board Freenove 7"
    Test pieces first, before the full monitor is redone for the real screen
    (164.5 x 98.5 glass, 10 mm glass + PCB, brass rings in the corners):
    - ScreenMountTest: the bezel's glass zone cut short (window, 166 x 100 pocket,
    rim 0.4 mm deeper than glass + PCB, 4 bracket bosses with the real pilot)
    - PixelScreenBracket (x2): flat bars on the brass rings, screwed to the bezel
    - ScrewPilotTest: self-tapping M2.5 pilots 2.0 to 2.4 mm
    - ScreenFitTest updated to the new glass (172 x 106 x 6)
    - new screen parameters (connectors from the user's photo marked [measure]);
    the old FNK0078H values are kept as OLD_* until the monitor is r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
    [PixelScreenBracket.stl, ScreenFitTest.stl, ScreenMountTest.stl, ScrewPilotTest.stl]
2026-11-08 pixel-desk: monitor for the blue-board Freenove 7" screen, no faux Pi
    The monitor now fits the user's real screen (164.5 x 98.5 glass, 10 mm glass +
    PCB, brass rings 6 mm from each corner edge):
    - bezel 184 x 132 x 20.7 mm: 166 x 100 pocket, window derived from the black
    border (picture 148.5 x 88.5 + 1 mm margin = 150.5 x 90.5, centred, at the
    glass plane), 2 bracket recesses flush with the rear face, 4 self-tapping
    M2.5 pilots for the brackets
    - PixelScreenBracket x2: screwed on the brass rings (M2.5 x 6) and on the
    bezel (M2.5 x 8), presses the glass on the lip; 12 mm free behind the PCB
    - CRT back 180 x 128 x 111 mm, no posts; stand/case interfaces unchanged
    - faux Pi (PixelScree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
    [PixelMonitorBack.stl, PixelMonitorFront.stl, PixelScreenBracket.stl, PixelScreenPowerAdapter.stl]
2026-11-08 pixel-desk: tape the screen on the bezel lip, no screws
    The user chose no screws: the blue-board screen is held by 1 mm double-sided
    foam tape between the glass's black border and the bezel lip.
    - removed PixelScreenBracket, its recesses and pilots, ScrewPilotTest and the
    screen's M2.5 screws
    - TAPE_T (1.0 mm): the glass seats TAPE_T behind the lip; the pocket depth and
    bezel follow (BEZ_D = FUNNEL + TAPE_T + SCR_T + 2 mm rim)
    - 8 small ribs in the pocket walls (SCR_RIB 0.6) centre the glass with
    0.15 mm all around while the tape sets; pocket stays 166 x 100
    - tape strips on the black border only: 6 mm on the sides, 3 mm top/bottom
    (the 5 mm border less the window margin: cannot be w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
    [PixelMonitorBack.stl, PixelMonitorFront.stl, PixelScreenBracket.stl, ScreenMountTest.stl, ScrewPilotTest.stl]
2026-11-08 pixel-desk: hold the screen with 4 posts of the CRT back, no tape
    The user chose no tape and no latches: the glass sits on the bezel lip and
    the closed CRT back presses on the screen's 4 brass corner rings.
    - PixelMonitorBack: 4 posts (9 mm, 2 ribs each, merged into the side and
    top walls / floor, free over 2 mm only), each ending in a 5.6 x 1.5 mm cup
    over its ring; 0.3 mm squeeze (SCR_SQUEEZE), optional 1 mm felt dot
    (TAKEUP_T); prints without supports (back-down); side grilles start above
    the lower posts
    - the back is now screwed on the bezel (2 screws from above, 2 from below,
    M2.5 x 8 into 4 tabs on the bezel's rear face): the posts cannot back off
    (hole play 0.15 mm < squee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
    [PixelMonitorBack.stl, PixelMonitorFront.stl, ScreenMountTest.stl, ScreenPostTest.stl]
2026-11-08 Pixel OS: Claude subscription, sounds, new scenes, phone modes and the Android app link
    What ran on the Pi on 8 November, on top of ce1b22a:
    - Claude: Pixel can answer through the Claude subscription (claude-agent-sdk,
    CLAUDE_CODE_OAUTH_TOKEN in /etc/pixel.env) instead of an API key
    (pixel/abonnement.py, tests/test_abonnement.py)
    - Quick menu: Éteindre and Redémarrer (a sudoers rule from install.sh for
    these two commands only), Téléphone (the QR code) and Poisson, a SON row,
    and THÈME only with two themes or more; on the Pi's screen, a swipe left
    on his face opens the QR code
    - Life: Christmas, New Year and snow, the next agenda events, too hot, Wi-Fi
    lost and back (8 new s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
    [abonnement.py, claude.py, scenes.py, system.py, test_abonnement.py, test_pixel.py]
2026-11-08 pixel-desk: symmetric window from the measured borders, power button on the monitor
    Window: the measured black borders (left 3, right 7, top 4, bottom 8 mm, seen
    from the front) give a 154.5 x 86.5 mm picture, 2 mm off-centre. The window
    is now symmetric and centred, 160.5 x 93.5 mm (at least WIN_MIN 152 x 93.5,
    from the printed test), so the whole picture shows whichever way up or
    mirrored the screen goes in, with >= 1 mm margin. Lip: 2.0 mm sides, 2.5 mm
    top/bottom (LIP_MIN 2.0, the back's posts hold the glass), with a 1.3 mm
    straight edge at the window (LIP_EDGE). ScreenMountTest follows.
    Power button: a real 12.2 mm hole for the user's 12 mm pre-wired button on the
    monitor's chin, botto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
    [PixelMonitorBack.stl, PixelMonitorFront.stl, ScreenFitTest.stl, ScreenMountTest.stl]
2026-11-09 pixel-desk: thinner centring ribs (0.45 mm to the glass): the test print was too tight
    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
    [PixelMonitorFront.stl, ScreenMountTest.stl]
2026-11-09 pixel-desk README: the ribs leave 0.45 mm
    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
2026-11-09 Pixel OS: a more CRT Rétro - grain, rolling refresh band, flicker, curved glass, a rare glitch
    Drawn on the canvas over everything, off with the CRT switch (view.crt_off) and
    with reduced motion.
    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
2026-11-09 Pixel OS: scene packs and events - notifications, Codex, timer, lights, weather, typing and actions can start scenes
    web/scenes/*.js add scenes through window.PixelScenePacks (loaded by both pages and the artifact);
    pixel/scenes.py reads the ids from all files. Scenes may list events (on), touch pools (pool) and a when() filter.
    The lab gets a row to trigger each event.
    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
2026-11-09 Pixel OS persona: scene packs can draw their own props (kit.prop), with the canvas and its helpers
    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
2026-11-09 Pixel OS docs: CAST.md, how to cast on Pixel and the other ways to cast to a Raspberry Pi
    In French. The user guide: the app's "Caster sur Pixel" panel, Android's "Partager -> Pixel" (it needs
    the app installed from an https address: Tailscale serve, a Chrome flag, or later the pixel-mobile
    app), three iOS Shortcuts posting to /api/cast, curl, the [cast] settings, the API, the security
    rules and the known limits. The research: AirPlay with UxPlay (package, Pi 4 and Pi 5, a user
    systemd service over the kiosk, a switch in Réglages, -pin), why Google Cast cannot be received,
    DLNA with gmrender-resurrect or built into Pixel, Miracast with MiracleCast (to avoid), WebRTC
    screen sharing with the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
2026-11-09 Pixel OS persona: the notifs pack - 50 reactions to notifications
    14 generic reactions (bell, binoculars, homing pigeon, envelope, falling off
    his chair, sunglasses, radar, mailbox, magnifier, rubber stamp...), 31
    keyword families read from the banner (messages, mail, calls, agenda,
    parcels, birthdays, errors, success, urgent alerts, storms, battery, music,
    video, money in and out, group chats, GitHub, timer, weather, Hue, Claude
    and Codex, likes, family, updates, power off, long texts, questions,
    shouting, food), and the rhythm: grumpy at night, overwhelmed by three
    notifications within a minute. 43 props of its own (kit.prop), every scene
    speaks beside him and keeps clear of the banner.
    C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
2026-11-09 Pixel de poche: the phone held sideways becomes a second, living Pixel
    - web/poche.js: in landscape (or with the "Pixel de poche" button) the phone shows his canvas alone,
    full screen, on his face, with the same theme, personality and scene packs, fed by the same snapshots.
    A long press pets him; shaken he is dizzy, tilted he leans and slides, out of the pocket "te revoila",
    the phone's battery, the Pi out of reach (he lives on, reconnects quietly). Wake Lock while awake,
    Fullscreen and landscape lock where allowed, a crisp canvas at devicePixelRatio, sides in the theme's
    background, no scroll, zoom or selection; silent.
    - pixel/poche.py: poche.touch (rate-limited news between the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
2026-11-09 Pixel de poche: the lab's phone frame, its tests, the French guide
    - Pixel Lab: "Voir sur un telephone" shows the pocket Pixel in a phone held sideways (also in the
    bundled artifact); buttons for the phone's senses and the two Pixels; demo-hub.js mirrors
    poche.touch and poche.voyage.
    - tests/test_poche.js (Playwright: Pixel 7 and iPhone 14 in landscape beside the Pi's kiosk screen,
    every theme, touch, long press, sensors, battery, server stopped and restarted, the voyage, portrait,
    the button, the lab frame) and tests/test_poche.py (the server's actions, the files that must agree).
    - README: a short "Pixel de poche" section.
    Cl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
    [test_poche.py]
2026-11-09 Pixel OS cast v2: YouTube, a solid player with the phone as its remote, and Pixel in the YouTube app's Cast button
    The player (web/ytplayer.js): YouTube's IFrame Player API on an iframe Pixel's screen makes itself, so that
    referrerpolicy="strict-origin-when-cross-origin", allow="autoplay; fullscreen", enablejsapi=1 and the origin hold from
    its first request; youtube-nocookie.com first, youtube.com once if YouTube refuses it there (152, 153). It sits above
    the page's scanlines (z-index 3) and under its command bar. The API script is loaded only for a YouTube cast. The end of
    the video (of the last one of a playlist) ends the cast; errors 2, 5, 100, 101/150, 152, 153 and "YouTube does not
    answ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
    [cast.py, commands.py, fake_ytcast.py, test_youtube.py, youtube.py, ytcast.py]
2026-11-09 Pixel OS docs: YouTube on Pixel (CAST.md, README, lab README)
    How to cast a YouTube link and use the phone as the remote, what each YouTube error means on Pixel's screen, how to
    switch on the YouTube app's Cast button and the TV code on the Pi (PIXEL_YTCAST=1 sh deploy/install.sh, [ytcast]
    enabled = true) and use it from Android, iPhone and a computer, the iPhone AirPlay route, the youtube.com/tv TV-mode
    fallback (documented, not built), the security of the sidecar, the API and state fields, and what could not be tried
    without a Pi and a phone.
    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
2026-11-09 Pixel OS persona: the « travail » scene pack - 60 reactions to Codex, the timer, the lights, the weather, typing and actions
    Codex: rolls up his sleeves, a crazy keyboard, coffee, a rocket countdown; a checkmark and
    confetti, thumbs up, a victory dance, a gold medal, an « OK » stamp; a facepalm, a bug hunt,
    he consoles Codex, crashes on his side, shakes his head, hunts the error with a magnifier.
    Timer: tomato mode, an hourglass he flips with, « à vos marques », he hides in a corner;
    a ringing alarm clock, a startled wake-up, a well-earned break, a runaway alarm clock.
    Lights: dazzled then sunglasses, disco ball, a light bulb, a spotlight.
    Weather by kind: sunglasses and a sun dance,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
2026-11-09 Pixel OS persona: the toucher pack - 62 reactions when you touch him
    Every touch pool gets its own scenes (web/scenes/toucher.js), with 37 props of
    the pack's own (kit.prop, all prefixed touche), solid shapes in the theme's
    colours so they show in Rétro and LCD:
    - a tap (calm, 15): the fingerprint detective, the cracked screen, a static
    shock, the doorbell, flight mode, hypnosis, the bouncing ball, the jump to
    the ceiling, the selfie, robot mode, jelly, the pancake toss, badum tss,
    the vanishing trick, the old tube switched off;
    - when he loves you (love, 7): heart eyes that boing, a hug against the
    glass, flying kisses, a heart balloon, a heart drawn in the air, the
    heartbeat, a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
2026-11-09 Pixel OS cast: the picture in its true colours, no Rétro effect while casting
    While anything is cast (a photo, a GIF, a video, a text, a link, YouTube), in every theme:
    - the theme's CRT layer (theme.fg: Rétro's grain, rolling band, flicker, glass and glitch; the LCD's grid) is not drawn;
    - the page's scanlines are hidden: the screen gets a "casting" class (style.css, lab.css);
    - the v1 green tint of the tube is gone: the picture sits on black, in its own colours, smoothed at high quality.
    Pixel's own UI around it (the little face in the corner, the stop hint) keeps the theme, and everything comes back as it
    was when the cast ends. « Couleurs d'origine » no longer means anything: hidden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
2026-11-09 Pixel OS cast: share a screen on Pixel (a computer by WebRTC, Android with ScreenStream, Apple devices by AirPlay)
    - A computer (or a phone whose browser can): the page « Partager mon écran » (GET /ecran, web/ecran.html) captures the
    screen (getDisplayMedia, feature-detected; 1280x720, 30 im/s, 4 Mb/s at most, H.264 first) and sends it by WebRTC to
    Pixel's screen, which answers (web/ecran.js) and draws the <video> on the canvas at 60 im/s, letterboxed, untinted.
    pixel/ecran.py relays the signalling on its own WebSocket (/ecran/ws): nothing before the one-time code shown on Pixel
    (6 digits, 3 minutes, 5 tries, spaced; also in the phone app) or the app's access code; only the Pi's o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
2026-11-09 Pixel OS docs: share a screen on Pixel, from each device (CAST.md, README, lab README)
    docs/CAST.md gets a part « Partager un écran », in French: what it does; from a computer (the page, the one-time code,
    the three ways to a secure context: the launcher, Pixel's https address, the Chrome/Edge setting; what to check when
    the picture does not come); from Android (ScreenStream, local mode, no PIN); from an iPhone, an iPad or a Mac (AirPlay:
    installing UxPlay, the settings, the PIN, how to stop, ports, a systemd note); iOS 27 Safari; the settings; how it works
    (routes, messages, state); security; and what could not be tried without a Pi. The v1 text about the tube's green and
    « Couleurs d'o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
2026-11-09 Pixel de poche: honest on http, the app keeps the screen on, real turns only, he lives on away from home
    Review fixes for the pocket Pixel (the phone held sideways):
    - http (the Pi's usual address) is not a secure page: no motion, battery nor Wake Lock. He now says so
    once on screen, never asks an iPhone for motion there, and a failed permission request is asked again
    on the next touch (it used to be asked once per page, ever). README says what needs https.
    - Pixel app (Android WebView, no Wake Lock): poche.js posts {mode: "pixel"} while he is shown and awake,
    and the page's own mode when he sleeps or leaves, through the existing App.tsx handler (no rebuild).
    - "online" no longer means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
2026-11-09 Pixel de poche test: a long press may play any cuddle, the packs' ones included
    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
2026-11-09 Pixel OS cast v2 YouTube: review fixes (sandboxed players, the app's next video in the same cast, DIAL on IPv4 only, no-code access from localhost only)
    - web/ytplayer.js, web/screens.js castFrame: the YouTube and Vimeo frames are sandboxed
    (allow-same-origin allow-scripts allow-forms allow-presentation
    allow-storage-access-by-user-activation), set before src. The IFrame API keeps working
    (same origin, postMessage), but a tap on the player's title, logo, end cards or ads
    no longer opens a window or navigates the kiosk away from Pixel's page.
    - pixel/ytcast.py: a stop from the sidecar waits STOP_WAIT (0.5 s) and a play cancels it.
    yt-cast-receiver stops before every new video (setPl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
    [cast.py, test_cast.py, test_youtube.py, ytcast.py]
2026-11-09 Pixel OS persona: the « surprises » scene pack - 50 rare and special moments
    Days of the week (Monday's empty battery, Wednesday's seesaw, Friday's confetti,
    the weekend hammock, Sunday evening's calendar), the seasons (spring flowers and
    a butterfly, the summer fan, autumn leaves, the winter ice cube), French dates
    (jour de l'an, galette des rois, Chandeleur, Saint-Valentin, Pi day, poisson
    d'avril, Easter computed, muguet, 4 May, fête de la musique, 14 juillet
    fireworks, la rentrée, pirate day, Halloween, Saint-Sylvestre countdown,
    Friday the 13th, 29 February, the full moon), clock gags (11:11, 12:34, 13:37,
    noon, midnight) and rare gags (CRT glitch, one pixel, fourth wall, stuck in t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
2026-11-09 Pixel OS cast: close the screen-sharing holes found in review (Origin null, DNS rebinding, lockout, sockets), AirPlay -nofreeze, IPv6 phones, lighter drawing
    - local_page (cast.py, the v1 rule /ws, /api/cast and the kiosk role build on): an Origin "null"
    (a sandboxed frame of any page shown on the Pi) no longer counts as Pixel's own page, and the
    Host must be localhost, 127.0.0.1 or [::1] with an Origin of exactly http(s)://<that host>, so a
    name that leads to the Pi (DNS rebinding) gets nothing without the access code.
    - /ecran/ws: an http(s) Origin must match a Host that is one of Pixel's names or addresses on its
    port (pixel.local, pixel, localhost, its current IPs). Origin null n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
    [airplay.py, cast.py, ecran.py, test_airplay.py, test_cast.py, test_ecran.py]
2026-11-09 Pixel OS cast: review fixes (access from the Pi, the player's sandbox and errors, the Pi's frame rate)
    - cast.local_page: Origin "null" (a sandboxed, data: or srcdoc frame of a page shown on the screen) no
    longer counts as Pixel's own page. The Pi itself also means a Host of localhost, 127.0.0.1 or [::1] and no
    proxy header (X-Forwarded-For, X-Forwarded-Host, Forwarded, X-Real-IP, Tailscale-*): through tailscale
    serve every device arrives from 127.0.0.1, and now needs the access code for /ws, /api/cast, /share and
    /cast/*. CAST.md says so.
    - screens.js, the YouTube/Vimeo player: sandboxed (allow-scripts allow-same-origin allow-presentation), so
    its links can neither open a window n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
    [cast.py, test_cast.py]
2026-11-09 Pixel for Android: build and sign the APK on Linux (scripts/build-apk-linux.sh)
    Copies the project to a build folder outside the repo, npm ci, expo prebuild,
    gradlew assembleRelease (arm64-v8a, retried on a failed download), then
    zipalign (16 KB pages) and apksigner with the key in PIXEL_KEYSTORE,
    PIXEL_KEYSTORE_PASS, PIXEL_KEY_ALIAS. Without a key it falls back, with a
    warning, to the template's public debug key, the one the WSL builds use.
    Checks the settings and the key before building; the passwords never reach
    npm or Gradle. Ignores *.keystore.
    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
2026-11-09 Pixel for Android: 1.1 - share to Pixel, the phone's notifications, the full Pixel de poche
    - Share to Pixel: a native share screen (ShareActivity, in a local Expo module, modules/pixel-native) takes a link, a
    text, a photo, a GIF or a video from any app's share sheet and streams it to Pixel's POST /api/cast with the access
    code, then says how it went (« Envoyé sur Pixel ✓ », Pixel's own error, « Pixel ne répond pas », too big) and goes
    away. HEIC or big photos go as a 1920 px JPEG. Not set up yet: it offers to scan the QR code.
    - The phone's notifications (off by default): a NotificationListenerService forwards the picked apps' new notifications
    to Pixel's new POST /api/noti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
    [telephone.py]
2026-11-09 Pixel sans Pi: the Android app no longer needs the Pi, Pixel lives on the phone
    The app opens straight on Pixel, on the phone itself: the real phone page (web/index.html) built into one
    offline file by tools/build_app_bundle.py (npm run bundle:web: pixel-mobile/assets/pixel-local.html, not in
    git), with Pixel Lab's in-page hub (lab/demo-hub.js) and the new web/local.js just before app.js.
    - web/local.js: makes the lab hub a real Pixel. No fake data: the lights, Claude, Codex, the agenda, casting
    and power say « Relie Pixel à ton Pi pour ça » (their screens, keys and commands); Système shows the
    phone's own measures; real weather from Open-Meteo for the city typed (« météo Lyon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
2026-11-09 Pixel OS nourrir: feed Pixel, his belly, his tastes, 24 foods in pixel art
    - pixel/nourrir.py: a gentle belly (empties in the day only, faster when gourmand,
    capped while the server is down, can be switched off), stable tastes (seeded,
    re-rollable), rate-limited meals with their reaction (favourite, liked, yuck,
    grumpy refusal, full, bloated, sugar rush, vegetables, robot food, a burp),
    data_dir/nourrir.json, snapshot "nourrir"; commands (« mange une pomme »,
    « donne-lui une pizza », « à table ! », « tu as faim ? ») and Claude's feed_pixel
    - web/scenes/nourrir.js: the menu read by the server, 12x12 sprites in the theme's
    colours, 15 scenes (one per reaction, the belly an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
2026-11-09 Pixel OS caractère: his character, personalised (traits, presets, names, habits)
    Eight traits from 0 to 100 (50 = today's Pixel, byte for byte): calin, grognon,
    bavard, farceur, energique, curieux, gourmand, studieux. 14 named presets plus
    « Surprise », fine-tuning sliders, his name, what he calls you, the mood of the
    day, quiet hours, may he sulk, does he speak.
    - pixel/caractere.py: caractere.json, snapshot "caractere", actions
    caractere.set / ajuste / reset / essai, typed commands (« sois grognon »,
    « plus câlin », « appelle-toi Bip »…), Claude's note and set_character tool
    (a system block of its own after the unchanged SYSTEM).
    - web/persona.js: one mechanism, scene we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
    [abonnement.py, caractere.py, claude.py, commands.py, test_caractere.py]
2026-11-09 Pixel for Android: 1.1 review fixes - sensors at 30 Hz, safer and kinder sharing, the listener really off
    - Pixel de poche: ask for HIGH_SAMPLING_RATE_SENSORS (a normal permission). Without it expo-sensors
    registers the accelerometer at SENSOR_DELAY_NORMAL on Android 12+, about 5 a second, and shakes
    were missed.
    - Share screen: work out the share on a worker thread (a cloud provider may download the file
    first), with a card shown at once; no more provider calls on the UI thread.
    - Share screen: read only content:// addresses of other apps, never file:// nor this app's own
    providers, so another app cannot make Pixel cast its private files (the access code).
    - Share screen: check a fi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
2026-11-09 Pixel OS exos: Pixel gives little math exercises
    pixel/exos.py: 15 kinds (additions to riddles) at 5 levels, 4 choices with the
    classic mistakes, a hint, a correction; one, a series, a table, the 60 s
    challenge; a second try, adaptive levels, daily goal, trophies, exos.json;
    commands (a bare number only while one is open) and Claude's start_exercise.
    web/exos.js: the view on the Pi's face screen in every theme (a screens.js
    add-on), the keyboard, his offer, and the phone's « Exos » panel.
    web/scenes/exos.js: his reactions. Lab mirror and panel. Tests.
    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
    [claude.py, commands.py, exos.py, test_exos.py]
2026-11-09 Pixel OS nourrir: review fixes (clock jumps, off means off, plate, phone panel, nourrir.json)
    - His belly: a gap of more than 5 min between two ticks (the Pi has no RTC: NTP
    moves its clock after boot; or a stalled loop) counts like the server being
    down: 6 awake hours at most, never below 25. A clock set back no longer
    freezes his belly or blocks his meals. Same rules in Pixel Lab's demo-hub.
    - nourrir.json: every value is checked when read (NaN, infinity, huge ints,
    times before 2000, lists where ids go, a broken last meal...); one out of
    place takes its default, and anything else gives a new belly, never a crash.
    - Switched off, no hunger at all: persona.js's old 'faim' moment g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
    [nourrir.py, test_nourrir.py]
2026-11-09 Pixel OS kiosk: swipes on the Pi's touch screen reach the page (touch-action:none)
    body.kiosk .screen canvas{touch-action:none} (added with Nourrir in 97841ec)
    changes existing gestures on the Pi, not only the food tray: without it,
    Chromium keeps a finger's vertical swipe for panning and the page gets
    pointercancel, so a swipe down from the top did not open the quick menu by
    touch. Pixel Lab's kiosk already had the same rule (lab.css). Said so in the
    rule's comment and in the README; if another branch adds the same rule, keep
    one.
    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
2026-11-09 Pixel OS caractère: review fixes (user events always answered, commands, « tais-toi », safer file, labels)
    - persona.js: curiosity (blasé: fewer answers, longer cooldown) weighs only the
    world's news (CAR_WORLD: notif, weather, lights-change, action, typing, codex-*);
    whatever you do to him or for him (timer, twin, poche, and future nourrir/exo
    events) is always answered. « Il parle » off hides chit-chat only: reminders,
    news and his reactions still show. Character helpers prefixed (CAR, car*), the
    'caractere' EVENTS line moved away from the shared append point.
    - caractere.py / caractere.js: non-finite numbers rejected (1e400 no longer stops
    the server; any unreadable file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
    [abonnement.py, caractere.py, test_caractere.py]
2026-11-09 Pixel OS exos: review fixes (one answer per exercise, his reactions, exos.json, commands)
    - An answer names its exercise (exos.repondre id; exos.passer id + etat): a double tap,
    a late screen or the same wrong answer twice never use up the second try, never skip
    the correction, never count against the next question of the 60 s challenge.
    - A wrong-shaped exos.json (null, a list, odd values) no longer stops the server: only
    well-shaped stats and settings are read back; setup() starts afresh on anything else.
    - « encore », « une autre »… start an exercise only while one is open or within 2 min
    after one ended by itself; after « Fini » or « stop exo » they are Claude's again.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
    [exos.py, test_exos.py]
2026-11-09 Pixel for Android 1.1.0: review fixes for the unified app (screen kept on, share link once, back button, poche play)
    - Keep-awake on the Pi's page: the keepAwake plug no longer turns it off on load
    start. react-native-webview 14.0.1 fires onLoadStart from doUpdateVisitedHistory,
    so app.js's history.replaceState (dropping ?t=) could undo {mode:'pixel'}. Plugs'
    start() now runs only for a new document (URL without query/hash) or a new
    WebView (usePlugs keys its page on the WebView's round), so a same-page history
    change can no longer stop Pixel de poche either.
    - Share card's "Relier à mon Pixel": pixel://relier?at=<ms>, taken once
    (localStore takeLink) and only while fresh (2 min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
2026-11-09 Pixel OS perso: the server wires the three together
    - Claude's get_status now tells his belly (and his last meal) and the
    exercises of the day; with an exercise open, its question and « do not
    give the answer, a hint if asked », never the answer or the choices.
    - His belly lives by the traits of the day: with « Humeur du jour » on,
    nourrir.py reads caractere.today_traits (the same as his screens).
    - « aide » names one command of each: mange une pomme, exo, table de 7.
    - nourrir.setup gets server.py's datadir, like caractere and exos.
    - test_exos.py: EXOS_PY_PORT=… for another port (default 8181 kept).
    Claude-Session: http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
2026-11-09 Pixel OS perso: one thing at a time over his face; his character in his meals and exercises
    - Who comes first on the face screen: a cast (snapshot "cast", when
    that feature is merged) > the quick menu > an open exercise > his offer
    « Une petite question ? » > Nourrir's tray and plate. The plate and the
    tray wait under an exercise or the offer (nourrir.js above()), no food
    hint during an exercise, no offer while the tray is open or a cast is
    on; under a cast the exercise stays open but is neither drawn nor
    touched (exos.js castOn()).
    - A gourmand Pixel asks for more after a meal (« Encore ! Il en
    reste ? »), a small eater has had enough; at 50 the same lines and the
    same p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
2026-11-09 Pixel OS perso x cast: a cast covers the exercises and the food tray, and they come back as they were
    - screens.js: Screens.casting (the real cast state, P.cast as castLive() reads it); frame() draws the cast instead of the
    screen and its add-on, and does not call Nourrir's over() under it.
    - exos.js, nourrir.js: they read Screens.casting instead of a stand-in snapshot key; under a cast the tray closes, no
    food hint, no offer, no plate, the exercise's keys are off (a touch ends the cast, as on 36422fd).
    - exos.py (and the lab's port): a question under a cast is not put away as left alone; it gets its 8 minutes again once
    the cast is over.
    - commands.py: the cast's words come before the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
2026-11-09 Tests: an env override for every fixed port (the defaults stay), so that suites can run side by side
    AGENDA_PORT (test_agenda.py), CAST_PY_PORT (test_cast.py), ECRAN_PY_PORT, ECRAN_HTTPS_PORT, ECRAN_TRAP_PORT
    (test_ecran.py), ECRAN_WEB_PORT, ECRAN_MJPEG_PORT, ECRAN_EVIL_PORT (test_ecran_web.js), POCHE_PY_PORT (test_poche.py),
    TELEPHONE_PORT (test_telephone.py), YOUTUBE_PY_PORT, YOUTUBE_PY_PORT_OFF (test_youtube.py), YOUTUBE_E2E_PORT,
    YOUTUBE_LAB_PORT; test_nourrir.py now reads NOURRIR_PY_PORT, as test_nourrir.js keeps NOURRIR_PORT (one name for two
    tests could not run them together). The others already had theirs.
    Claude-Session: https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
    [test_agenda.py, test_cast.py, test_ecran.py, test_nourrir.py, test_poche.py, test_telephone.py, test_youtube.py]
2026-11-09 Pixel for Android 1.2.0 (versionCode 3), and the docs: caractère, nourrir and exos, with and without a Pi
    - app.json, package.json, package-lock.json and the native module's build.gradle: 1.2.0, versionCode 3.
    - pixel-mobile/README.md: what is new in 1.2 (the three on the phone, kept, seeded from the Pi; the menu's panels; his
    belly while the app is closed; the plate of the Pixel de poche; a cast over an exercise), what is kept, the menu,
    installing 1.2 over 1.1, the files.
    - pixel-app/README.md: the app 1.2, Pixel sans Pi with the three, restorable(key, (v, at)), Le personnaliser with or
    without a Pi, the cast over everything, Pixel Lab's panels together, the tests and their port ove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
2026-11-09 pixel-desk: screen test v2, a 168 x 102 pocket and a window on the picture
    The printed ScreenMountTest was too tight: the screen did not go in, it needs
    2 mm more both ways. SCR_CLR 0.75 -> 1.75: the pocket is 168 x 102 (fit test,
    mount test and the real bezel alike), the ribs leave 1.45 mm to the measured
    glass. The glass sits 1 mm higher in the monitor (SCR_BOTTOM 25) so the power
    button's pocket keeps 2.2 mm to the glass pocket; the monitor grows 2 mm.
    The symmetric window showed the black border: up to 5 mm on the right and at
    the bottom, a little at the top and on the left, just as on the print. The
    window now follows the picture (black border 3 left, 7 right, 4 top, 8 bottom,
    seen fro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
    [PixelMonitorBack.stl, PixelMonitorFront.stl, ScreenFitTest.stl, ScreenMountTest.stl]
2026-11-09 Exos after review: the lab's commands are the server's, word for word; the nudge counts the time shown
    - web/lab/demo-hub.js: the typed commands are pixel/exos.py command() copied exactly (its lists, KIND_WORDS and
    patterns: « termine », « j'arrête », « aide-moi », « mes exos », « mes statistiques », « calcul mental », « défi de
    maths », « une énigme logique », « 10 questions », « exo très difficile », « exo de mathématiques », « exo avec des
    additions »…), asked by command() right after the cast's words, as commands.py does. Pixel sans Pi runs this code:
    on the phone these phrases went to Claude's « Relie Pixel à ton Pi » toast and left the exercise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
2026-11-09 Caractère: the same name on the Pi and on the screens, accents and vowel signs kept
    pixel/caractere.py clean_name() kept only Python's \w, which has no combining marks: « प्रिया » became « परय » and a
    « Zoé » typed as e + ´ became « Zoe » on the Pi, while web/caractere.js (\p{M}) kept them. Both now NFC-normalise
    and keep letters, marks and digits; the JS cuts at 16 or 20 characters as Python counts them (never half of one).
    test_caractere.py compares both on 11 names.
    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
2026-11-09 Pixel sans Pi after review: the back button closes a panel, a game is never cut short, the phone's own life stays
    - The back button: app.js tells the app whether a panel is open ({sheet}) and gives PixelSheet.close(), the topmost
    first; plugs.ts closeSheet() runs it before anything else, on the phone's Pixel (LocalPixel.tsx) and on the Pi's
    page (App.tsx). Before, back reopened the menu over the open panel, and back again left the app. An older Pi's page
    says nothing: the button does what it did.
    - local.js ping(): a touch or a key anywhere on the page is use (the Caractère, Nourrir and Exos panels are page
    buttons, not his screen), and an open exercise is busy. Linked.tsx no longer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
2026-11-09 Docs: the quick menu over a cast, the back button and a game never cut short, what the tests now check
    - pixel-app/README.md: the quick menu opens over everything, a cast included (it was put under the cast); the app goes
    back to the Pi only when nobody plays on the phone; the new checks of test_local, test_exos, test_caractere and
    test_perso.
    - pixel-mobile/README.md: the back button closes an open panel first; the app is never pulled back to the Pi in the
    middle of a game.
    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
2026-11-09 Souvenirs, album photo et carnet d'humeur: server modules, screens, phone sheet, lab mirror
    pixel/souvenirs.py: his memories (your birthday, the day you met, his records read
    from exos and nourrir, a capped timeline, souvenirs.ajoute for other features,
    souvenirs.fete for today) and the private mood journal (once a day from 17:00, never
    at night nor in quiet hours nor while he sleeps; never in Claude's prompt).
    pixel/album.py: POST /api/album and GET /album/NAME with the cast access rules,
    bytes checked (JPEG or still WebP, size, dimensions), count and size caps.
    web/album.js: PixelAlbum.snap(reason) on Pixel's own screen only, never over a cast,
    without the info line nor the banner. web/sou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
    [album.py, claude.py, commands.py, souvenirs.py]
2026-11-09 Les amis de Pixel, the server: friendship codes, an end-to-end sealed ntfy relay, visits
    pixel/relais.py: an ntfy-compatible relay client (one streaming subscription to every
    topic wanted, opened only when there is one; reconnects with backoff and resumes with
    since=) and the box: AES-256-GCM with the topic as associated data, HKDF topics and
    keys, scrypt-stretched friendship codes, X25519 for each pairing.
    pixel/amis.py: becoming friends with a code (three of 512 simple words and a number,
    40 bits, 24 h, once), identity cards (id, his Pixel's name, preset, theme, look),
    one topic and one key per direction, replay/age/recipient checks, rate limits in and
    out, visits both ways with a program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
2026-11-09 Son look: eye shapes, colours, accessories, seasonal and night outfits for Pixel
    - pixel/look.py: the look's catalogue and rules (shapes, colours, slots, items, outfits),
    validation, look.json with history, the look.* actions, typed commands and the set_look tool
    - web/look.js: the same rules in the browser, window.PixelLook (get, with, clean), the
    drawing of shapes, colours and accessories for the living face and the pack, the panel
    - pack52: small documented hooks (no-ops without a look) so the pack's faces can wear it
    - themes.js: shapes, colours and accessories in all six themes' own styles
    - scenes/look.js: the little scenes (mirror, night cap, seasons), lab panel « Son look »
    Co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
2026-11-09 Souvenirs: tests (Python and Chromium), README section, presence on a real touch, panel polish
    tests/test_souvenirs.py: the dates on a fixed clock (29 February, the year's turn,
    31 January), the files (restart, broken, oldest file), the timeline cap, his records,
    when he may ask, privacy by default, the commands and Claude's tool, the album's
    bytes, caps, access rules and paths. tests/test_souvenirs.js: the mood question on
    the kiosk and the phone, the party and its photo without the info line nor the
    banner, a photo from the phone's button reaching its album, no photo during a cast,
    the slideshow, the sheet in 6 themes, the same rules in Pixel Lab, Pixel sans Pi's
    album in IndexedDB. His in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
    [souvenirs.py, test_souvenirs.py]
2026-11-09 Les amis de Pixel, the screens: a friend on a visit beside him, the phone's « Ses amis », the lab's Bip
    web/amis.js, a screens.js add-on over his face screen: a friend's Pixel on a visit
    beside him (the face of the theme, his own look through PixelLook.with, his name
    under him, his lines, his props), this Pixel moved to the left and shrunk, the
    host's programme played scene by scene; his own Pixel away: a little house « Chez
    Bip », the time left, « Rappelle-le »; « Me demander avant »: Oui / Non; his code,
    big; a coucou, a sticker, a new friend peeping in. Une chose à la fois: a cast,
    the quick menu and an open exercise come first; the visit comes before his offer
    and the food tray.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
2026-11-09 Son look: tests, cached accessory drawings, polish after review
    - tests/test_look.py: catalogue, cleaning, look.set and friends, seasons and nights with a fixed
    clock, look.json and « Remettre comme avant », the typed phrases through commands.py, set_look,
    get_status (64 typed phrases), the same rules in web/look.js case by case, a demo server started twice
    - tests/test_look.js: every eye shape and accessory in the six themes on both faces (drawn,
    following his face, never over his eyes or the info line), colours, seasons by date, his
    pyjama with a stand-in for his habits, the phone's sheet at 390x844, Pixel Lab, Pixel sans Pi
    - accessories on the vector faces drawn once per theme,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
    [look.py, test_look.py]
2026-11-09 Les amis de Pixel, the guide: docs/AMIS.md and the README; a coucou waits while he sleeps
    docs/AMIS.md: becoming friends (the code, its QR code, a mistyped word),
    the visits (both ways, « Rappelle-le », when a friend cannot), coucous and
    stickers, the parents' settings and switch, what protects the children,
    Pixel sans Pi and Pixel Lab, your own ntfy relay; then how it is made: the
    relay protocol, the sealed box, the code's 40 bits and scrypt + HKDF, the
    pairing and its X25519 exchange, the identity card (ready for a village),
    the per-direction channels, the message types, a visit's programme, the
    state "amis", the actions, the commands, Claude's tool, amis.json, and
    what only a real secon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
2026-11-09 Tests: the hunger hints checked in the daytime whatever the hour; the cast name check no longer flaky
    test_nourrir.js moved the page's clock to 23:30 for the night checks but left the
    day checks on the real time, so run at night they failed (no hint at night, as
    designed). The day checks now run at 10:30 on the page's clock.
    test_cast.py checked that the original file name was not in the random one; a
    random name ending in "x" (« …x.webp ») failed it about once in three runs. It
    now checks the stored name is not the original one.
    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
    [test_cast.py]
2026-11-09 Wiring: a friend's visit is a memory souvenirs knows; the app's menu offers the new panels; 1.3.0
    - amis: the visit's memory and photo use souvenirs' own « ami » type and reason
    (its first-visit record, its 👋 and « Une visite »); they used « ami-visite »,
    which souvenirs kept as an unknown type, so the first visit was never a record.
    - pixel-mobile: PANELS gains look, souvenirs, album and amis (in the menu in that
    order after Caractère), with their labels in PixelMenu.tsx.
    - Pixel for Android 1.3.0, versionCode 4.
    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
2026-11-10 One order for the buttons under the keys and for the lab's panels
    Each feature adds its own button under the keys when its script runs (some only with
    the first state), so the row came in load order. app.js now keeps it in one order:
    Miroir de Pixel, Agendas, Caractère, Son look, Nourrir, Exos, Souvenirs, Album, Amis,
    then the Android app's link. In Pixel Lab, each panel goes just after « Exos de
    maths », so the script order gives Son look, Souvenirs, Les amis.
    Tests follow: test_perso.js checks the whole row in that order, test_look.js its
    place, and the lab checks of test_souvenirs.js and test_amis.js only that their
    panel comes after « Exos de maths ».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
2026-11-10 Ses habitudes: his day, his mini-games, his laughs, his fears, his own phrases
    - pixel/habitudes.py (habitudes.json): his schedule (wake-up 7:30, bed 21:00, an optional nap,
    weekend times; a bedtime after midnight and the DST nights work), his state published as
    habitudes.etat (eveille, reveil, sieste, coucher, nuit) and habitudes.dort; his routine
    (stretch, yawn, teeth, night-light, goodnight); 4 server-judged games (cache-cache,
    pierre-feuille-ciseaux, attrape-etoiles, Simon) that wait under a cast or an exercise;
    32 kid jokes, grimaces, funny noises; fears (storm from the weather, the dark, a spider,
    the void) and courage over the days; taught phrases (5 a moment, 60 character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
    [claude.py, commands.py, habitudes.py, nourrir.py, test_habitudes.py]
2026-11-10 Friends: the sticker row stays open while the list is drawn again; a card with only what draws him
    - web/amis.js: the friends' list is drawn again whenever the amis snapshot changes
    (and my card carries my look), so the sticker row a child had just opened closed
    at once. The open row is now remembered across redraws.
    - pixel/amis.py: my card carries the look without the screens' own keys (change,
    avant, sans): what with() needs to draw him, without a change's time that made
    every friend's list redraw.
    - tests/test_look.js: the birthday check moved the lab to 9 November and never back,
    so the typed-command comparison with the Pi failed on any other day.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
    [amis.py]
2026-11-10 Wiring: his pyjama follows his bedtime and night, not his nap; a won game's photo is « Une partie gagnée »
    - look (look.py and look.js, the same rule): with his habits there, the night outfit
    comes with their night and his bedtime routine (« coucher »), not with a nap, where
    he sleeps in his clothes; a bare {dort} (a stand-in) still says it all.
    - habitudes: a won game's photo uses souvenirs' own reason « jeu » (« Une partie
    gagnée », 🎲); « jeu-gagne » was an unknown reason, shown as « Un souvenir ».
    - test_look.js: the night and the typed commands start from today at 14 h in the lab:
    run at night, there was no « look-dodo » scene to see (he was already asleep).
    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
2026-11-10 1.3.0 review: what a page or a friend's Pixel can make the server do is capped; broken files never cost the others
    The ten findings of the security and robustness review of Pixel 1.3.0, each with its tests.
    1. One WebSocket message no longer holds the server: habitudes.to_min trims a text and reads
    16 characters at most, without the outer \s* (it was quadratic on long whitespace); /ws takes
    3 MiB a message at most (the largest a page sends: web/reglages.js's calendar file, 2 MiB,
    about 2.2 MiB in JSON; longer: that socket is closed, 1009); souvenirs.ajoute and
    habitudes.apprendre cut a long text before cleaning it.
    2. What a friend's Pixel may make ours do, even one that keeps n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
    [album.py, amis.py, claude.py, habitudes.py, relais.py, souvenirs.py, test_amis.py]
2026-11-10 Four together: one order over his face, one night, games and visits apart, souvenirs that wait
    Look, habitudes, souvenirs/album/humeur and amis share his screen, his night and their data:
    - One order on the kiosk, written once (web/screens.js ORDER, add-ons by name, each still
    deciding when it is on): boot, cast and quick menu first, then an open exercise ('exo'),
    a game ('jeu'), a friend's visit / « Chez Bip » / the knock / his code / a peek ('amis'),
    souvenirs' views ('souvenirs'), his game offer and night veil ('habitudes'), the exercise's
    offer ('exo-offre'); Nourrir's tray and plate under every add-on (Screens.addonTop). The
    four per-feature Nourrir guards are gone; exos an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
2026-11-10 Loose ends of the 1.3.0 review: no visit photo the album would refuse, one time parser on both sides, look.json put aside
    - web/amis.js: the screen takes a friend's visit photo only when the album keeps it (visite.photo, the « retour »
    event's photo: one a day with each friend), so no pose for a photo that never shows.
    - web/habitudes.js toMin: trimmed and 16 characters at most, like pixel/habitudes.py to_min (no slow regex on a long
    text in Pixel Lab or Pixel sans Pi).
    - pixel/look.py: a look.json that cannot be used is put aside as look.json.illisible (like the other files), never
    written over; tests/test_look.py checks it.
    - web/souvenirs.js: the album viewer has no « Enregistrer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
    [habitudes.py, look.py, test_look.py]
